MERTAYDIN46/EE_464_hardware_project/EE464 Hardware Project Presentation.pptx

## EE464 Hardware Project Presentation

Deniz Boran KARACA-
Mert Yaşar AYDIN-
Canberk DUMAN-

## Design Procedure

## Parameter Selection

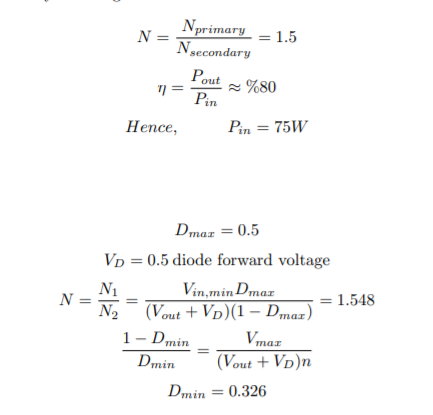
[picture p64: figure]

## Mosfet:

- Mosfet Rating:

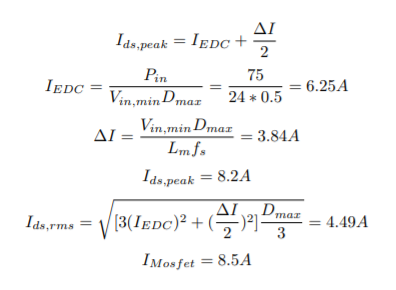
[picture p65: figure]

## Magnetizing Inductance

- Checking boundary magnetizing inductance:
- Choosing magnetizing inductance:

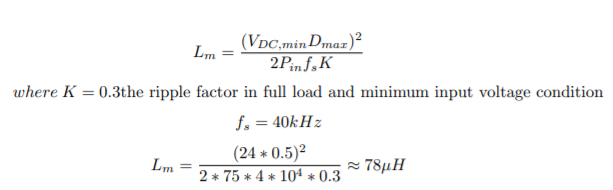
[picture p66: figure]

## Magnetic Design

- Average current of the transformer:

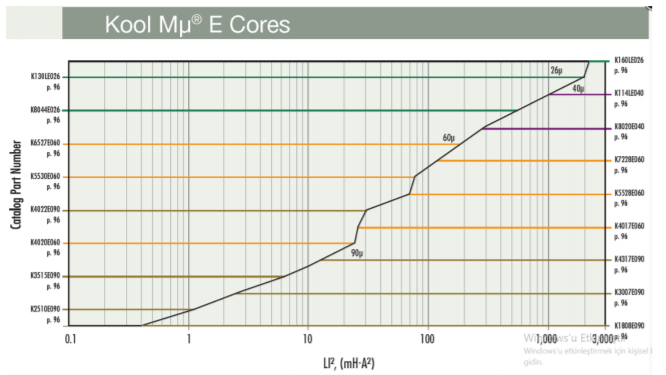
[picture p67: figure]

## Slide 7

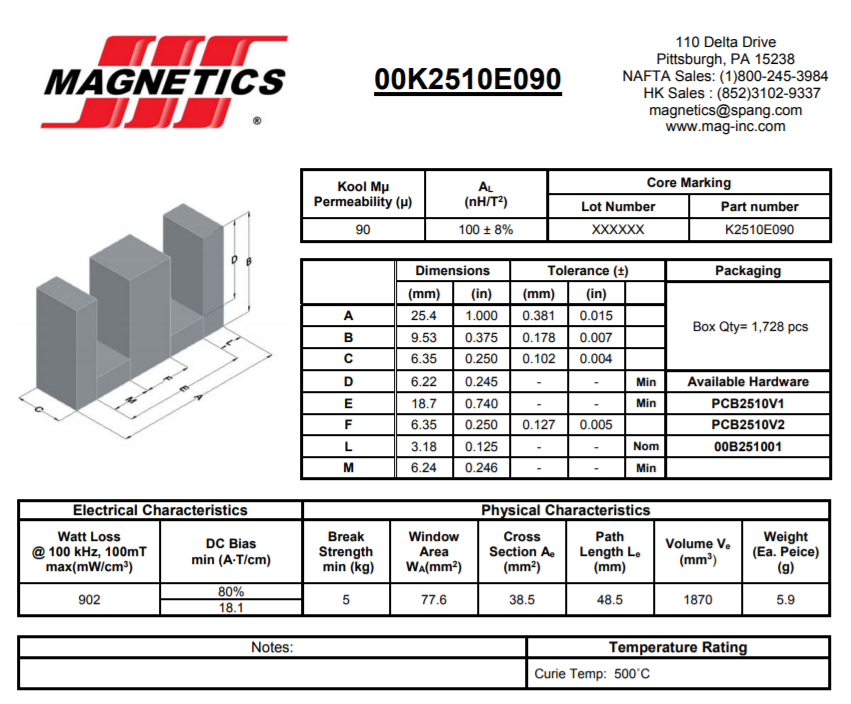
[picture p68: figure]

## Slide 8

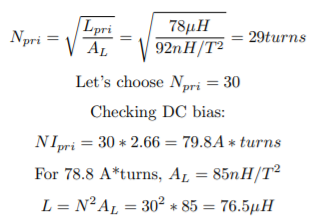
[picture p69: figure]
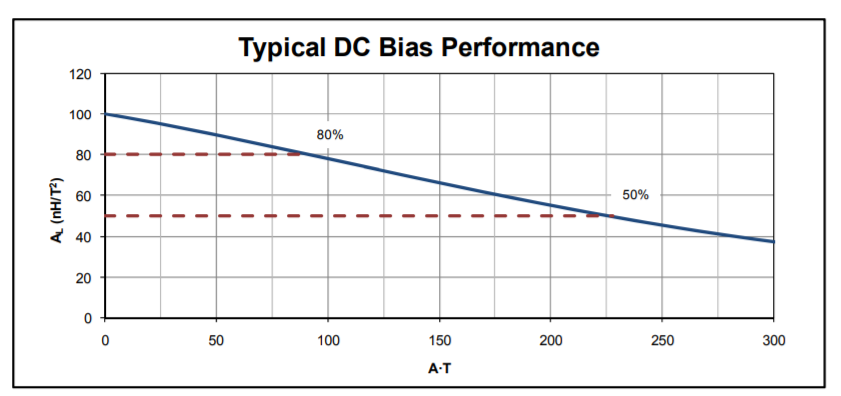
[picture p70: figure]

## Slide 9

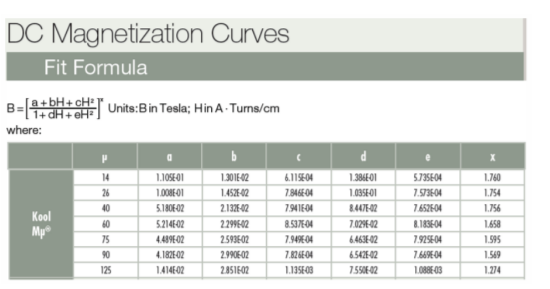
[picture p71: figure]
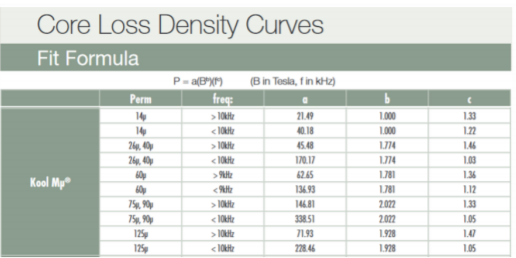
[picture p72: figure]

## Wire Selection

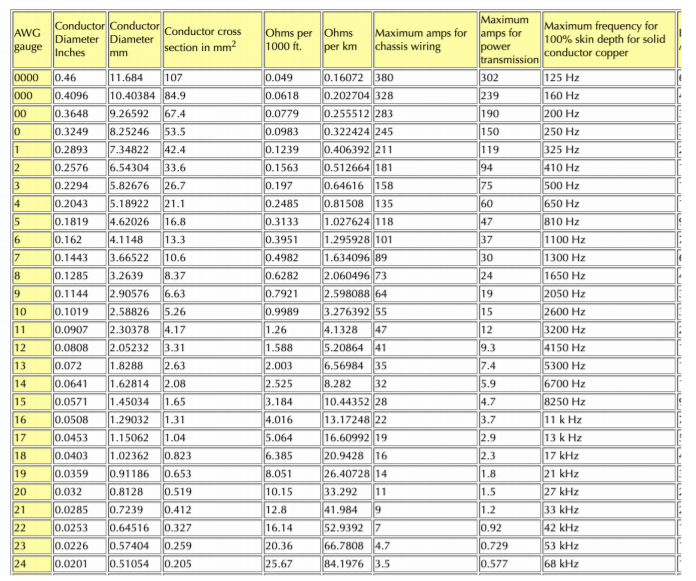
[picture p73: figure]
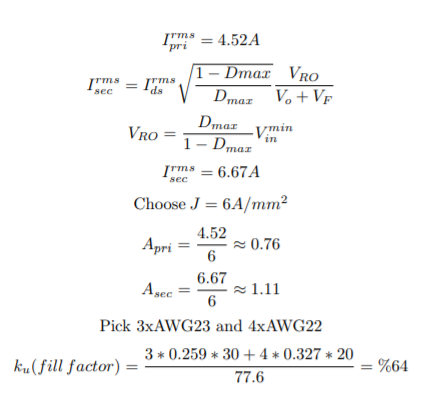
[picture p74: figure]

## Copper Loss:

- Neglecting proximity effect:

## Diode and Output Capacitor

- Diode:
- Output Capacitor:

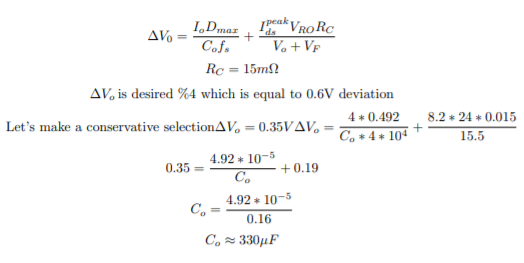
[picture p75: figure]

## Component Selection

## Slide 14

- Mosfet:
Assuming %30 spike
- Diode:

## Transfer Function Derivation

## On-Off States

- Averaging:

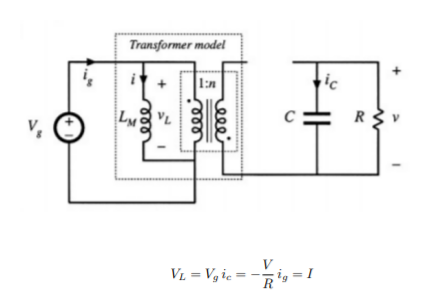
[picture p76: figure]
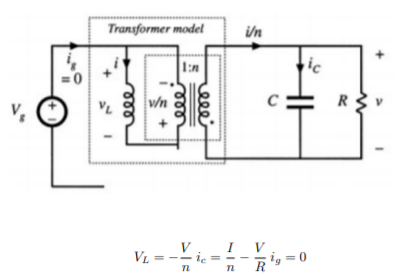
[picture p77: figure]

## Slide 17

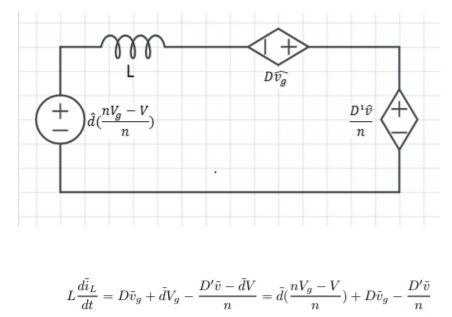
[picture p78: figure]
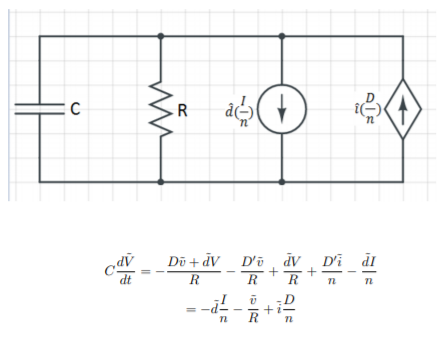
[picture p79: figure]
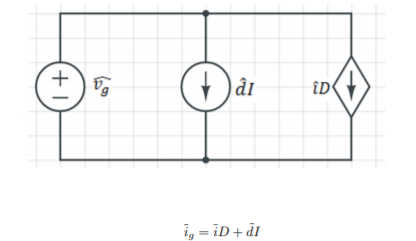
[picture p80: figure]

## Overall Circuit

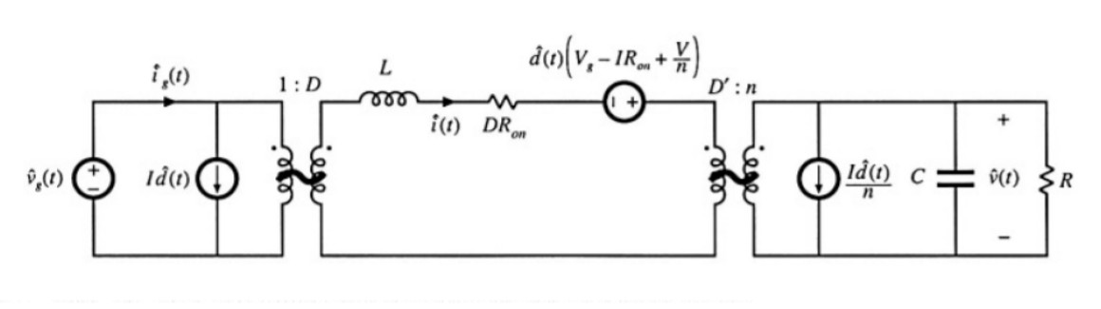
[picture p81: figure]

## Superposition

- Killing Voltage Source

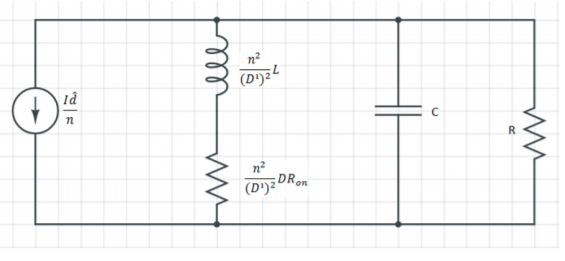
[picture p82: figure]
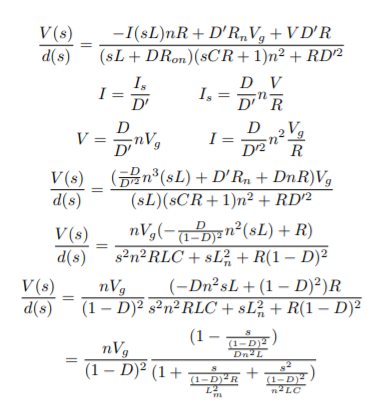
[picture p83: figure]

## Slide 20

- Killing Current Source

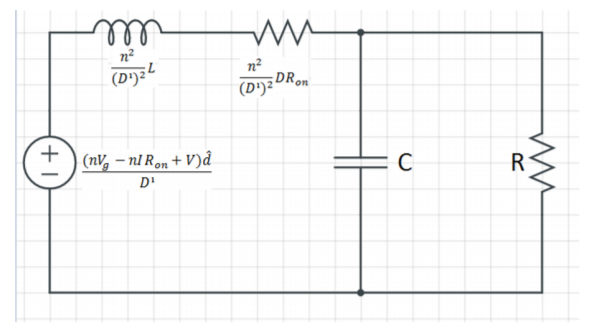
[picture p84: figure]
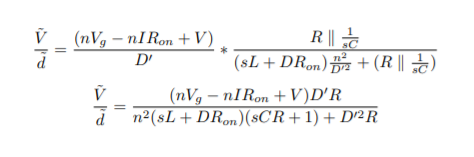
[picture p85: figure]

## Arranging Terms

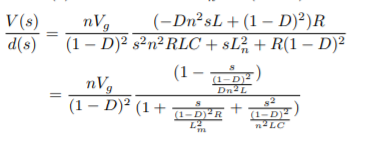
[picture p86: figure]

RHP Zero and Double pole!

## Compansator Design

## Bode Plots

- ESR of capacitor introduces a zero at:

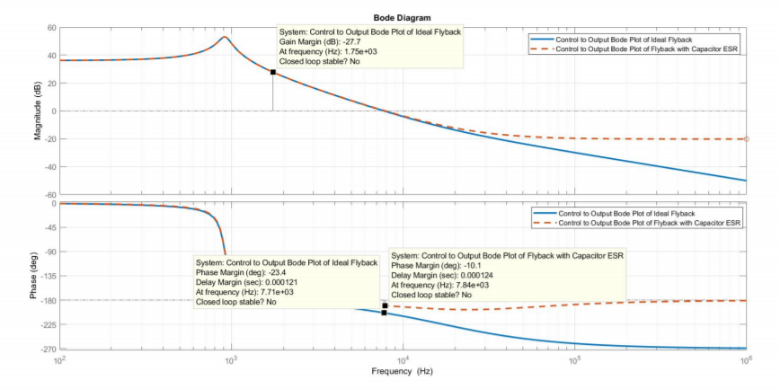
[picture p87: figure]

## Slide 24

- Crossover frequency selection:

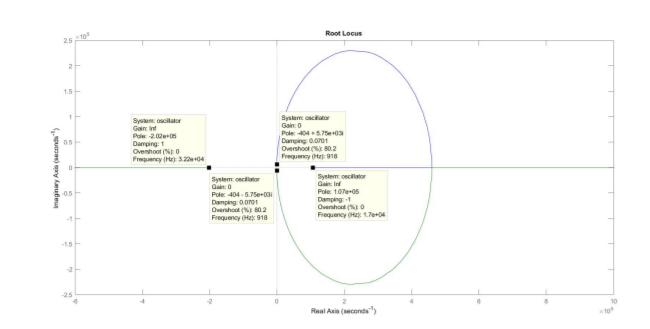
[picture p88: figure]

## Selecting Type of Error Amplifier

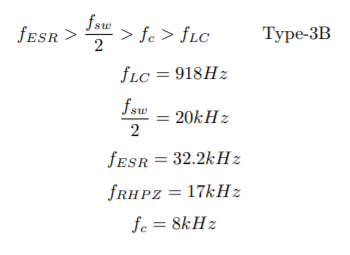
[picture p89: figure]
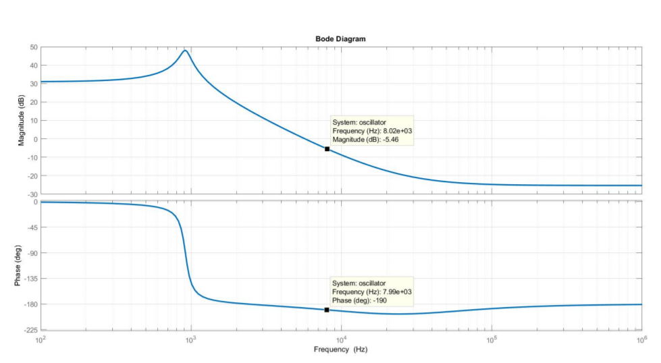
[picture p90: figure]

## Finding Components

- K-method:

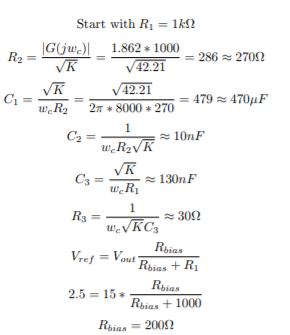
[picture p91: figure]
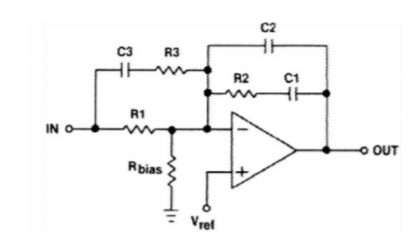
[picture p92: figure]

## Slide 27

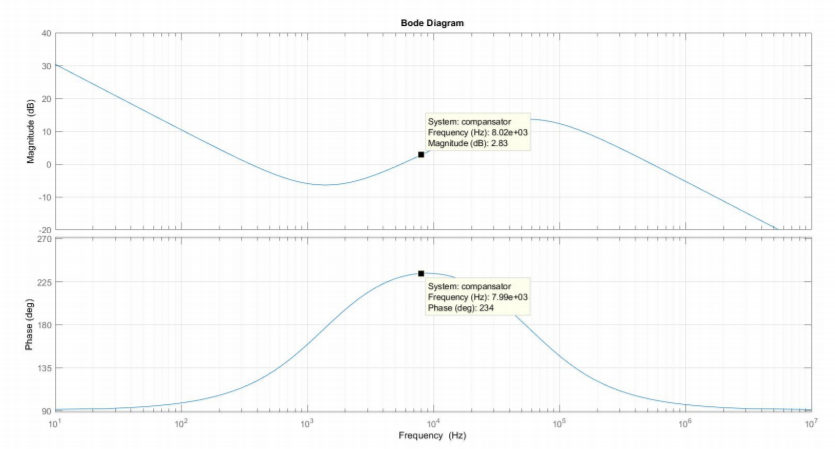
[picture p93: figure]
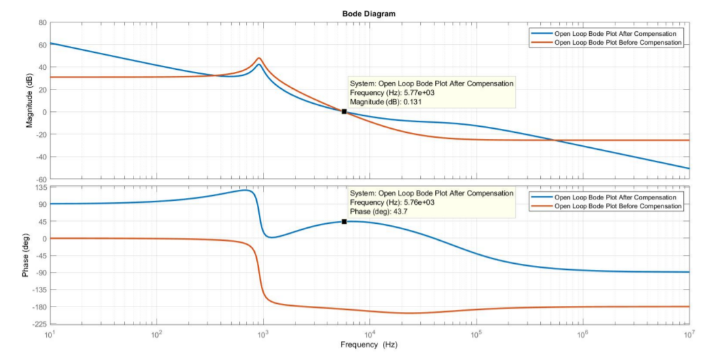
[picture p94: figure]

## Thermal Analysis

## Mosfet Heatsink

- Operating junction temperature is chosen 90 Celcius.

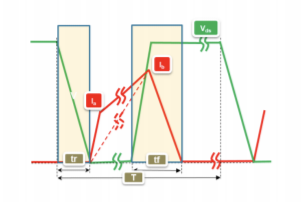
[picture p95: figure]
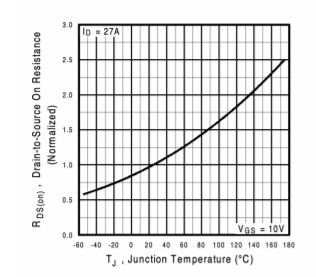
[picture p96: figure]
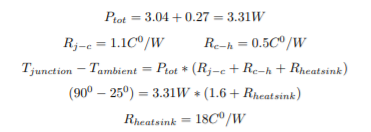
[picture p97: figure]

## Slide 30

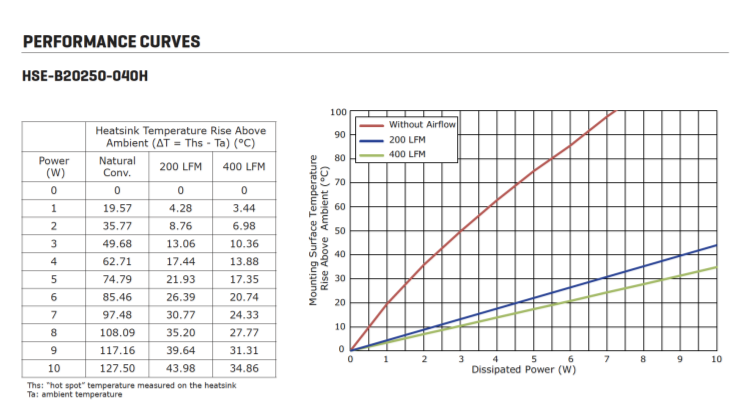
[picture p98: figure]

## Diode Heatsink

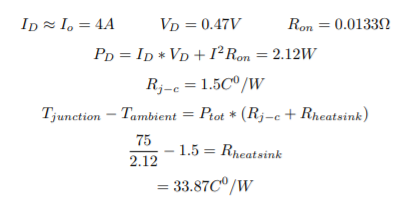
[picture p99: figure]
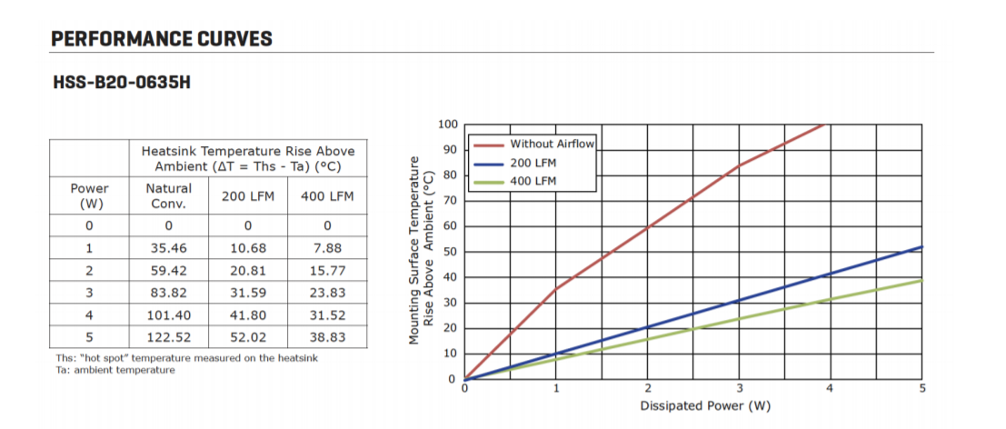
[picture p100: figure]

## Test Results

## With Controller Spice Model

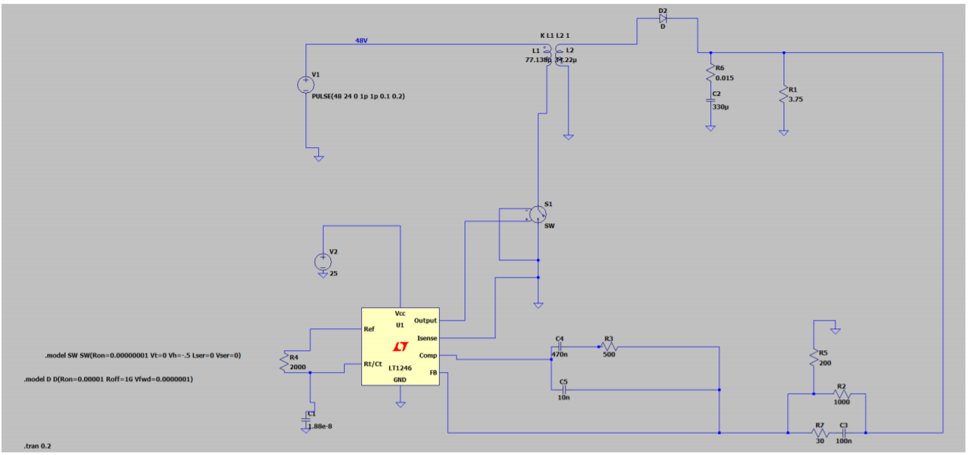
[picture p101: figure]

## Slide 34

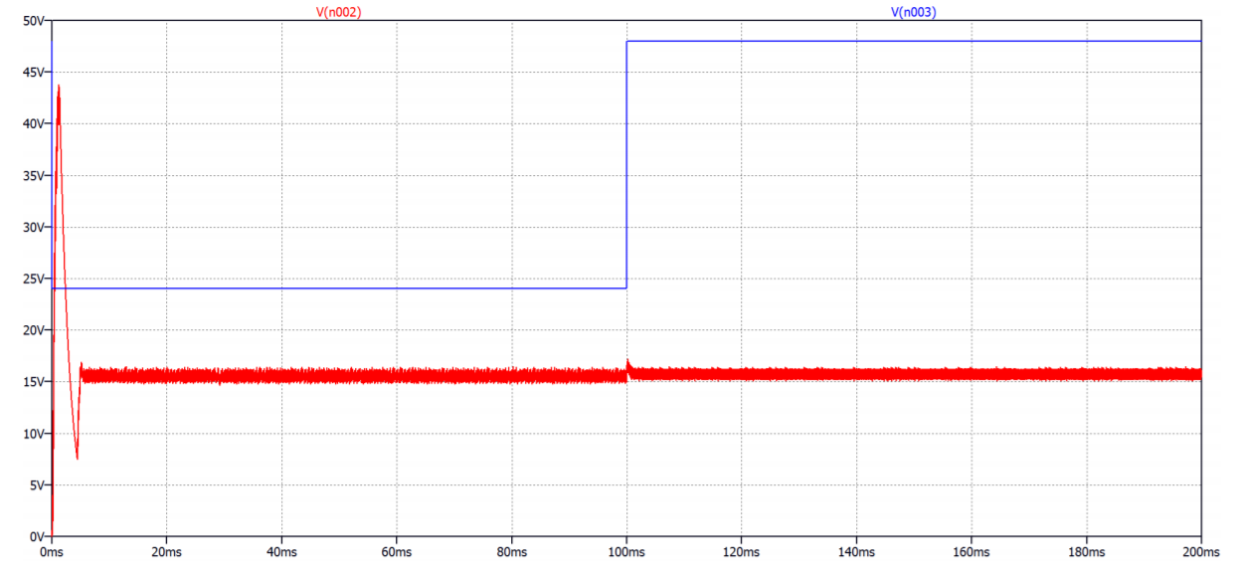
[picture p102: figure]

## Slide 35

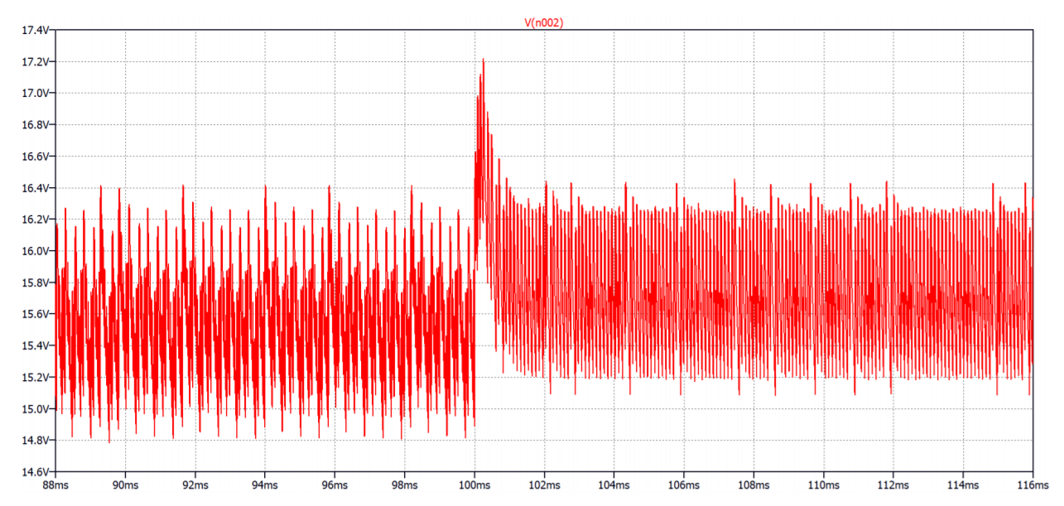
[picture p103: figure]

## Without Controller

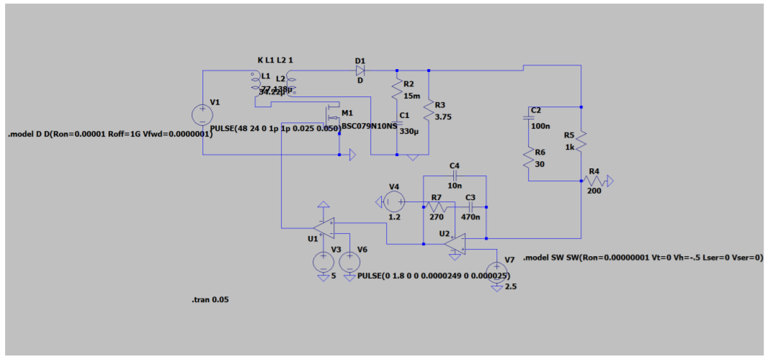
[picture p104: figure]

## Slide 37

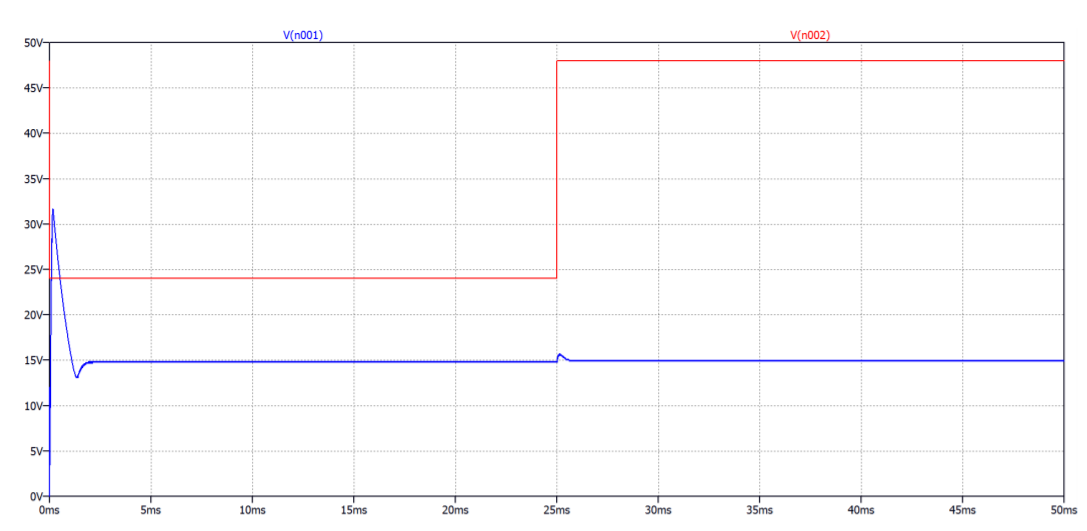
[picture p105: figure]

## Slide 38

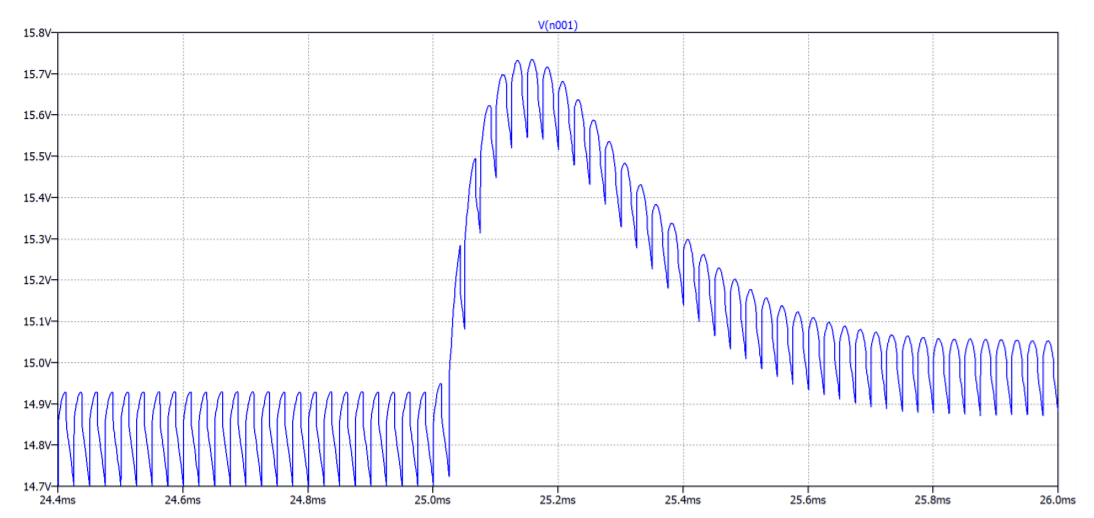
[picture p106: figure]
