MERTAYDIN46/EE_464_hardware_project/EE464_Hardware_Project_Simulation_Report.pdf

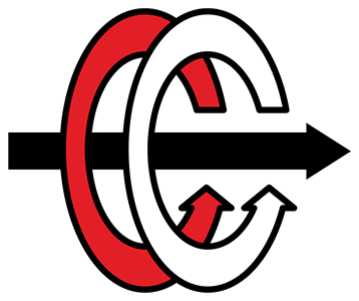
[picture p123: figure]

## MIDDLE EAST TECHNICAL UNIVERSITY

EE464- STATIC POWER CONVERSION-II

Hardware Project Simulation Report

Deniz Boran KARACA 2093987

Mert Ya¸sar AYDIN | 2093334
Canberk DUMAN | 2030450

Date: 23/03/2020

1

## Table of Content

1 Introduction | 3
2 Design Choices | 3
3 Design Process | 7
4 Simulation Results | 16
5 Conclusion | 20
6 References | 21

2

## 1 Introduction

This report is prepared to discuss design decisions, component selections and provide computer simulations of the regulated power supply for the EE464 hardware project.
There are mainly two different topologies and three different specs for each topology. In this report, both flyback and forward converters will be investigated with their advantages and disadvantages. The selection of topology and project design are explained with reasoning and simulation results.

## 2 Design Choices

### 2.1 Flyback Converter

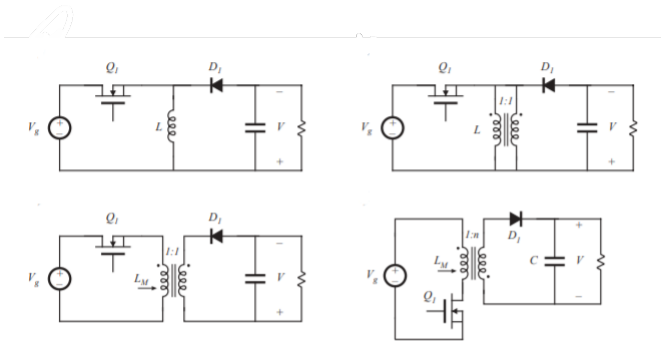
[picture p124: figure]

Figure 1: Derivation of the flyback converter.

The flyback converter can be described as the buck-boost converter with the isolated inductor wires, as seen in Figure 1. The isolation between primary and secondary sides is provided by a transformer. The transformer turns ratio depends on design specification and application, but mainly used to prevent results of possible internal failures on output and provide multiple outputs by adding more windings with a single input. They are generally used in the low to mid power range, less than 100 watts application. It also provides wide input voltage range.

3

Input output voltage relation of the flyback converter:

Vout

Vin

=

N2
N1

D
1 − D

There are also two different modifications of the flyback converter which are two-transistor and paralleling flyback converters, can be seen in Figure 2. These topologies can be answer of higher efficiency, lower cost or higher system reliability. Possible usage of these two modifications for our project will be discussed later.

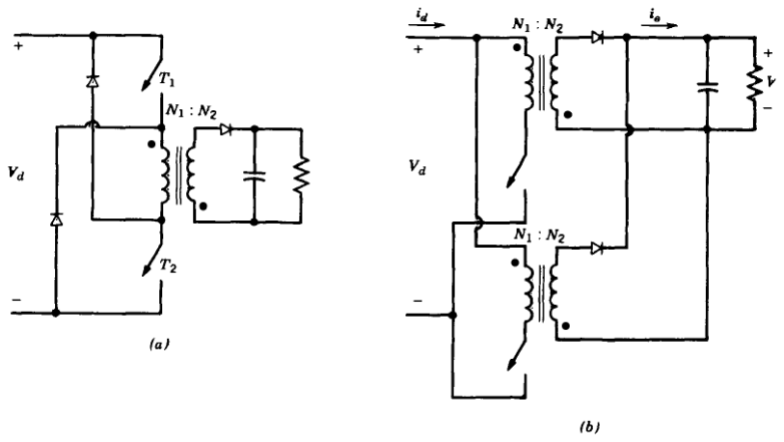
[picture p125: figure]

Figure 2: Two-transistor and paralleling flyback converters, respectively.

4

### 2.2 Forward Converter

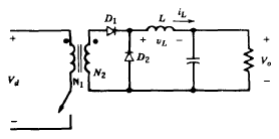
[picture p126: figure]

Figure 3: Practical forward converter.

The forward converter is derived from the buck converter employs a transformer for isolation between input and output sides, can be seen in Figure 3. It is possible to provide both higher and lower output voltages like the flyback converter. Even the forward converter looks like the flyback converter, it works in a different way. The forward converter passes energy directly to output by transformer, in contrast to the flyback converter which stores energy during conduction period and pass during non-conducting period. Moreover, since energy is not stored, gap-less core can be used.The forward converter is commonly used in the power range below 200 W.

Input output voltage relation of the forward converter:

Vout

Vin

=

N2
N1

D

In a practical forward converter, the transformer magnetizing current should be considered for a proper operation. To feed back the magnetizing energy to input supply which refers the higher efficiency, a third magnetizing winding is necessary.
There are also two different modifications of the forward converter which are two-transistor and paralleling forward converters like flyback, can be seen in Figure 4.

5

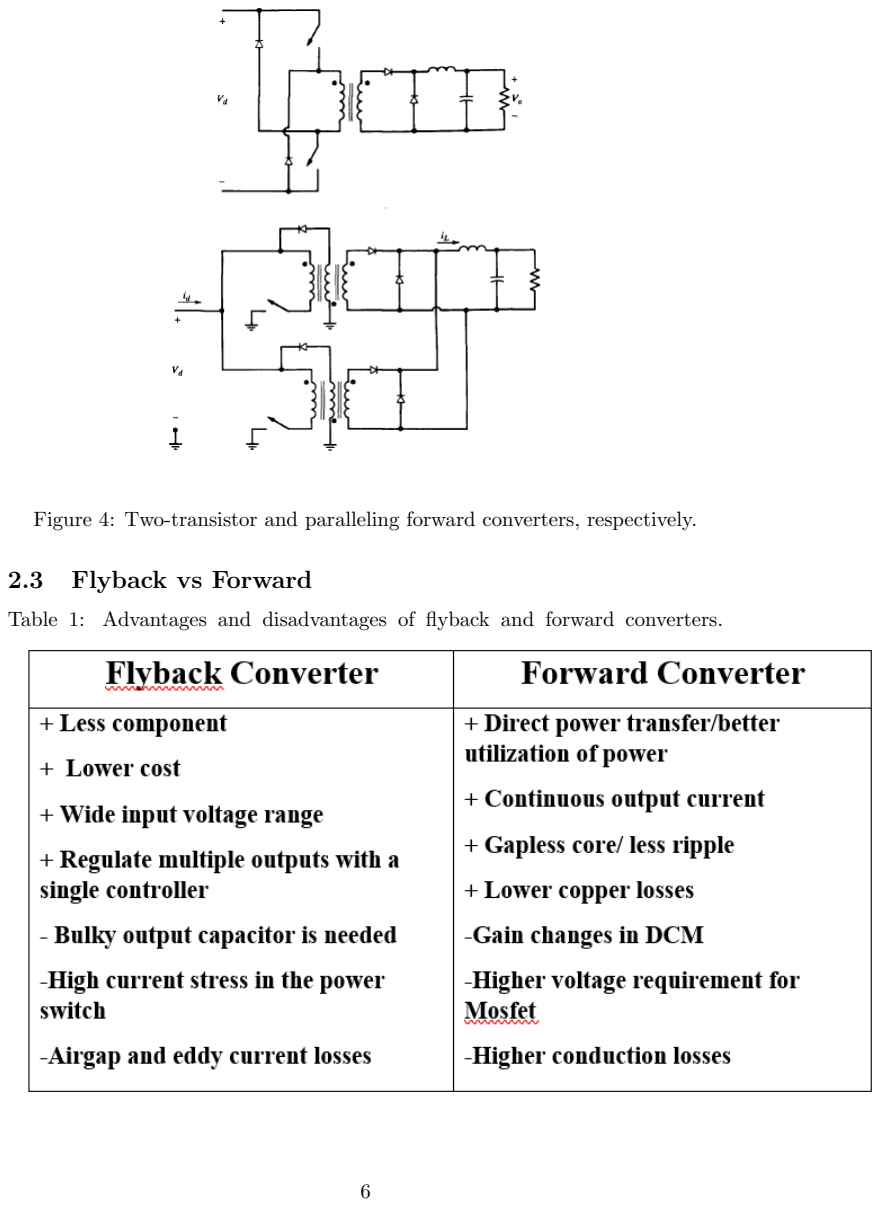
[picture p127: page 6]

Figure 4: Two-transistor and paralleling forward converters, respectively.

### 2.3 Flyback vs Forward

Table 1: Advantages and disadvantages of flyback and forward converters.

6

The main advantages and disadvantages of two topologies are discussed in Table 1. In hardware project, wide input voltage range is a important factor to reach stable and desired output voltage. In this respect, the flyback converter is better option. In addition to that, simplicity of less components and lower cost advantages of it are the main reasons to choose flyback converter topology. Compact design and high power density is another benefits of the flyback converter. Moreover, the flyback converter offers higher efficiency in low voltage range. The Fly 1 is preferred by taking all of these into account.

## 3 Design Process

Design specifications of the converter are very important during the design procedure. They are provided in Figure 5.


Figure 5: Design Specifications of the Flyback 1 Converter

Design procedure is explained step by step below. This procedure is simplified a bit. The more accurate design is made via the excel sheet prepared. That excel sheet is added to Github.

### 3.1 Step 1: Choosing Operating Condition

The first step is choosing the proper operating condition according to specifications. Flyback converters are used in continuous (CCM) or discontinuous (DCM) conduction mode. In order to ease the selection of operating condition, a helpful comparison shown in Table 2.

7

Table 2: DCM and CCM comparisons of the flyback converter.

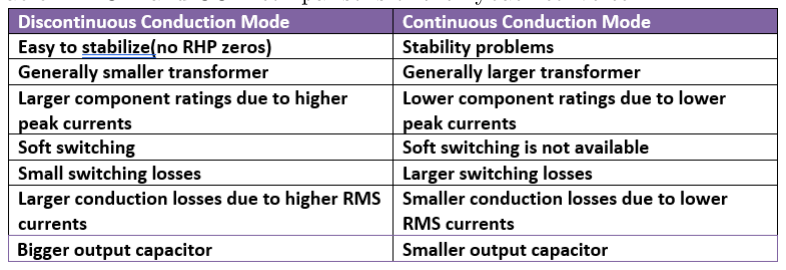
[picture p128: figure]

Note that CCM operation is mostly used high power and large output current applications. For that application, DCM is selected due to relatively low 4 A output current and 60 W output power. It provides stable operation. However, efficiency is important for that design. Therefore, three major implementations are considered in order to compensate the conduction loss of the DCM operation. Firstly, MOSFET having lower ON resistance is chosen. Secondly, a schottky diode is used. Lastly, resistance of the cables are lowered by using bigger ones, and fewer turns are used in transformer.

### 3.2 Step 2: Choosing Switching Frequency

There is a simple switching frequency trade-off. Higher switching frequency means higher switching loss and smaller components. Since an efficient converter wanted to be designed, a relatively small 40 kHz switching frequency is chosen.

### 3.3 Step 3: Choosing Controller:

First stage

Initially, since we are new in the converter control techniques and integrated circuits we are planning to use simpler controller while starting the project. For that purpose, we choose the “FAN 6604” IC. It has 6 pins and various features like built in soft-starting and current mode control. Also, its pwm frequency is very close to the one that we determined before therefore, we can use the all of out ratings with that controller.
FB pin still needs compensation network to determine performance of the controller. Gate pin is the output of that controller which is connected to “gate” of the power mosfet. Also, from the “SENSE” input we can give peak current feedback from the output of the converter and by this way the current mode control can be done. Additionally, HV pin provides soft starting by keeping PWM at very low values until its internal charges become full.

Second stage

In order to regulate the output voltage we need to implement some kind of feedback. In order to implement controller, if we are successful at first stage,we

8

are planning to use “UCC28780” integrated circuit .Beside providing PWM control feature for regulation purposes, it has multiple features that satisfy the requirements of the project. For example,it provides synchronous switching for active clamp snubber configuration which reverse the energy of the leakage winding to the source.
In order implement this operation pin 4 and pin 5 should be connected to the high side and low side gate drivers of the mosfets. Also, it can provide soft starting through the current sense input (pin 7). And another important feature of it is current mode control.

### 3.4 Step 4: Choosing Reflected Voltage

Making reflected voltage larger causes larger drain source voltage and lower peak current of the primary side MOSFET, and lower voltage stress on diode. Moreover, it also affects the maximum duty cycle of the converter. Maximum duty cycle generally has to be less than 65% due to possibility of transient problems. Reflected voltage is chosen as 31 V by considering all. Reflected voltage is symbolized as VRfor the rest of the design steps.

### 3.5 Step 5: Choosing Expected Efficiency

Choosing expected efficiency between%70-80 is reasonable. It is chosen as 80% since the output voltage is relatively higher, and an efficient flyback wanted to be designed.

Pin,max =

Pout
η

=

60
0.8

= 75W

VMosf et(on) =

Vin,min + VR

1 + | Vin,min∗VR
| Pin,max∗RDS(on)

Assuming on state resistance of a MOSFET having low ON resistance is 0.05 ohm:

VMosf et(on) = 0.275V

Dmax =

VR

(Vin,min − VMosf et(on)) + VR

Dmax = 0.566

Primary side peak current:

Ipri(peak) =

Pin

Vin,min − VMosf et(on)

2

Dmax
Ipri(peak) = 11.17A

9

### 3.6 Step 6: Transformer Design

Firstly, maximum primary inductance value provides converter operate in DCM is found.

Lpri,max =

Vin,min ∗ Dmax

Ipri(peak) ∗ fsw

Lpri,max = 30.1µH

Increasing primary inductance over the maximum value can make converter operate in CCM for high duty cycle values. In other words, if the maximum value is chosen converter is in the boundary between DCM and CCM for minimum input voltage value.

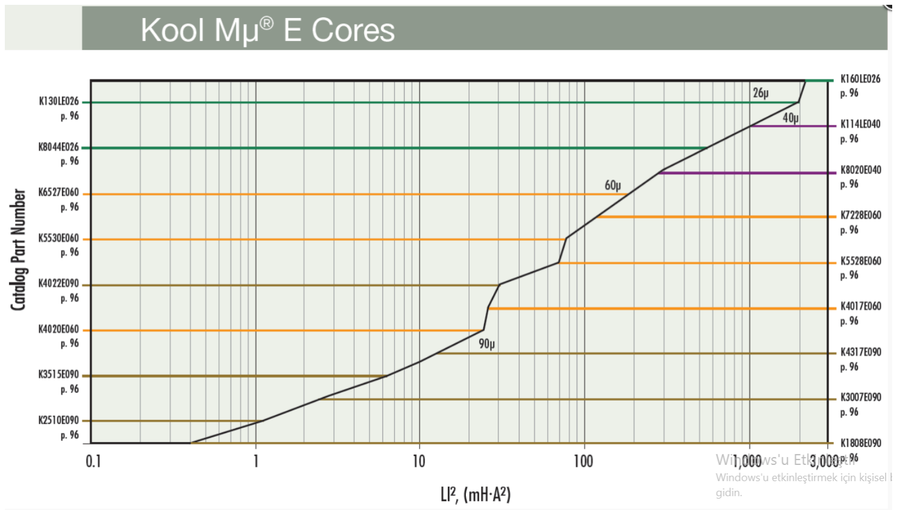
[picture p129: figure]

Figure 6: LI² Characteristics of Kool Mu E Cores [1]

In order to select the proper core, the graph in the Figure 6 is investigated.

Lpri,max ∗ I

2

pri(peak) = 3.75mH.A²

K3515E090 core can be used from 0.1 to 7mH.A²
. Since it is small and capable for that operation, it is chosen as the transformer core. Turn ratio is simply:

n =

VR

Vout + VD

10 where VD is the diode forward voltage and generally around 0.5 V for schottky diodes. Therefore,

n = 2

Then, minimum primary turns are found with two different equations as follows:

Npri,min =

Lpri ∗ Ipri(peak)

Bmax ∗ Ae
Npri,min = 4turns

Note that Ae can be found from core datasheet [2], and saturation flux density is shown in Figure 7.

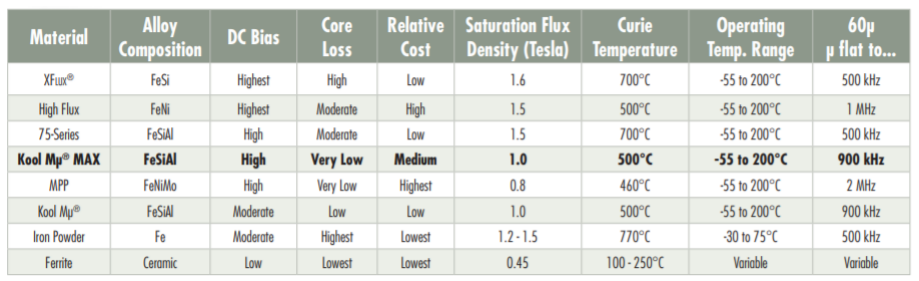
[picture p130: figure]

Figure 7: Material Properties of Kool Mu [3].

To avoid magnetic saturation, second equation is:

Npri,min =

r
Lpri
AL

=

r
30.1 ∗ 10⁻⁶
146 ∗ 10⁻⁹

= 14.36turns

AL value is found from core datasheet. Primary side turn number is selected as 16 turns considering both equations. Therefore Nsec becomes 8 turns.
Then, required minimum airgap to get desired primary inductance value is calculated as follows:

Lgap = µ0Ae

N²
pri
Lpri

−

Ic
µr

= 0.126mm

lc is core magnetic path length and µr is the relative permeability. They are found from core datasheet.

Step 6: Choosing Wire Size

Choosing a proper wire for transformer windings is very crucial since the wires need to carry such primary and secondary side currents. First step for wire size

11 selection is estimating total transformer loss.

Ptot =

∆T

Rth(core)

∆T = Tmax − Tamb

By limiting T to 100 ◦

, and assuming ambient temperature is 25◦ :

∆T = 75C

◦
(1)

Moreover, Rth(core) can be estimated as:

Rth(core) = 23 ∗ AP⁽⁻⁰.37)

AP = WAAe = 12.7cm⁴

Window area is also found from core datasheet.

Ptot = 8.3W

Secondly, actual flux swing is found as follows:

∆B =

Ipri(peak)Lpri

NpriAe

10⁴

∆B = 0.25T

By neglecting the core losses, primary and secondary side resistances are:

Rpri =

Ptot
2I

2
pri(RMS)

Ipri(RMS) = Ipri(peak)

r
Dmax
3

= 4.822A

Rpri = 0.178Ω

Rsec =

Ptot
2I

2
sec(RMS)

Isec(peak) = Ipri(peak)

Npri

Nsec

= 22.32A

Isec(RMS) = Isec(peak)

r
1 − Dmax
3

= 8.55A

Rsec = 0.083Ω

Minimum primary and secondary side wire cross sectional area:

Apri,min =

p100NpriLt

Rpri

Asec,min =

p100NsecLt

Rsec

12

Lt is the turn length and depends on the bobbin used, and it can be assumed as 50 mm for that core. p100 is the limited temperature copper resistivity, and 2.303 ∗ 10⁻⁶Ωcm for 100 C
◦
. Therefore,

Apri,min = 1.03mm²

Asec,min = 1.1mm²

Before going further, considering skin effect is very important. For a reliable operation, the radius of conductor is smaller than skin effect.

skindepth =

r p100

π ∗ fswµcopper

skindepth = 3.26mm

Lastly, proper wire size is determined according to chart in Figure 8. AWG 16 cable is selected for now. However, cable size can be enlarged in order to decrease the conduction losses later. AWG 16 cable is also appropriate for skin effect consideration.

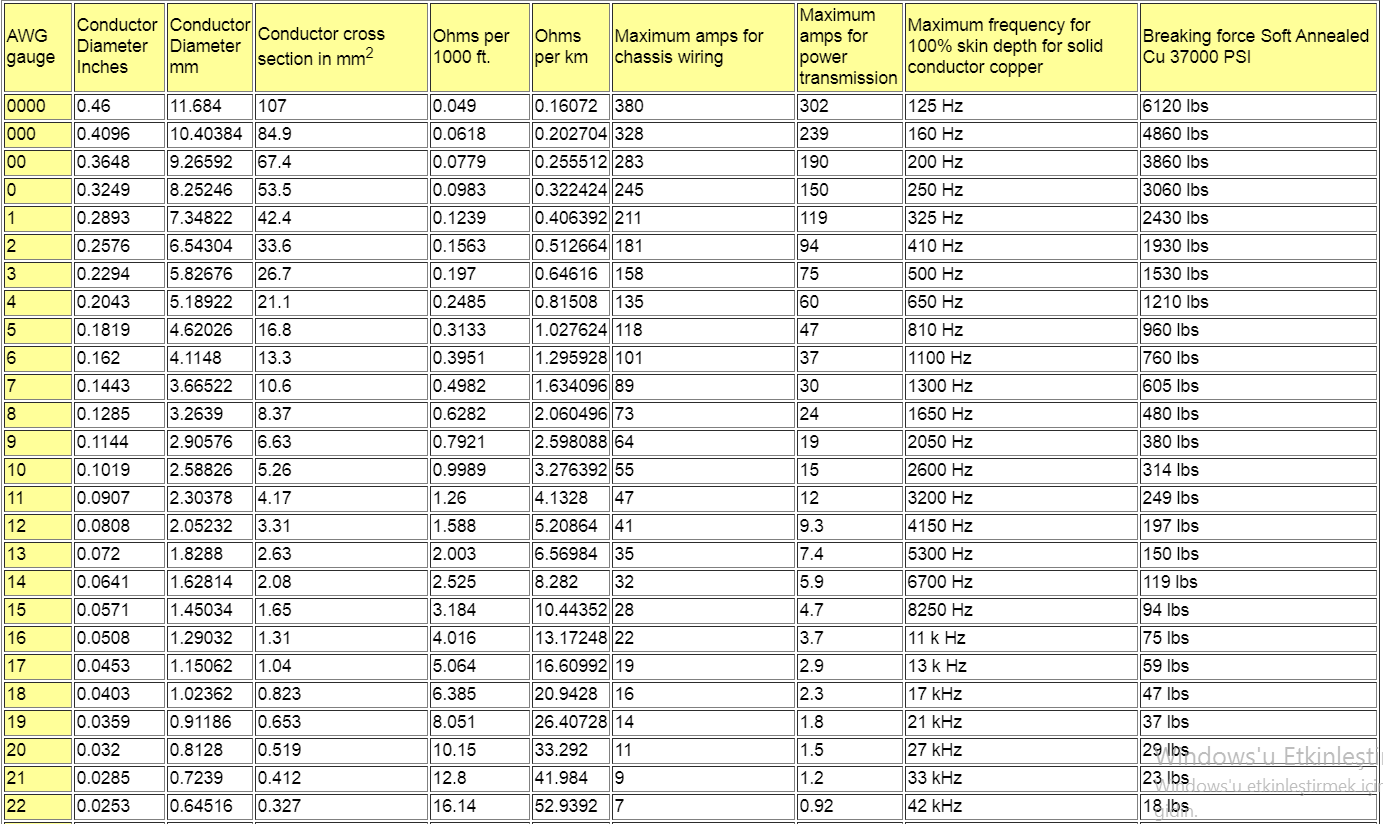
[picture p131: figure]

Figure 8: AWG Copper Chart

Step 7: Choosing MOSFET

As mentioned before, since rectifier operates in DCM switching losses are small. In order to reduce the conduction losses, a MOSFET having small ON resistance is selected.

13

Maximum current flowing through the MOSFET is primary side peak current. Although considering RMS current is pretty enough during component selection, peak currents provides some margin and more reliable operation. Therefore,

Irated(Mosf et) > Ipri(peak) = 11.6A

Voltage rating of the MOSFET is calculated as follows:

Vrated(Mosf et) = Vin,max + VR + Vspike

Assuming expected maximum spike voltage is 30 % of maximum input voltage. Note that that spikes are decreased with a clamp circuit.

Vrated(Mosf et) = 48 + 31 + 14.4 = 93.4V

For that purpose, 100V 33A 0.044 ohm IRF540NSPbF [4] MOSFET is selected.

### 3.7 Step 8: Choosing Diode

Similarly, in order to decrease the conduction losses, a schottky diode is chosen.

Vrated(diode) = Vout + Vin,max

Nsec

Npri

= 39V

Irated(diode) > Isec(peak) = 22.32A

Secondary peak current is considered due to more reliable operation. Moreover, 30% margin is added to voltage rating. At the end, a schottky diode whose ratings are over 50V and 22.32 A is selected. For this purpose, 80 V 30 A VT3080S [5] is chosen. It’s forward voltage drop is typically 0.5-0.6 V.

### 3.8 Step 9: Choosing Output Capacitor

Since rectifier is operating on DCM, and higher peak currents flow through the components, ESR of the capacitor becomes important.

Ccap >>

IoutDmax

fswVripple

Ncp is a value between 10-20, and allowable maximum ripple for that case is 0.6
V. Taking it as 10,

Cmin = 9.3µF

Calculating maximum ESR:

ESRmax =

Vripple

Isec(peak)

= 0.0268Ω

Vrated(cap) = Vout = 15V

At the end, 50 V 330 µF 23 mΩ aluminium electrolytic capacitor [6] is chosen.

14

### 3.9 Step 10: RCD Clamp Circuit Design

During the off time, high voltages may occur due to leakage inductance of the transformer and they may damage the MOSFET. Therefore, a clamping circuit shown in Figure 9 is designed. The components of that circuit depends on the primary leakage inductance, so they may be changed after measuring the leakage inductance in practice. For theoretical calculations, leakage inductance is taken as 3% of the primary inductance.
Note that there are different type of clamping techniques, and the selected topology may be changed since it may decrease the efficiency in a considerable amount. For now, a simple RCD snubber is functional enough.

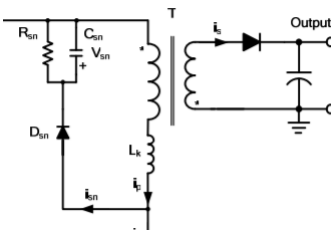
[picture p132: figure]

Figure 9: RCD Snubber Topology [7]

In that topology, higher R value causes low power loss but high voltage spike. Moreover, lower R value causes more oscillations. Components will be chosen according to simulation results considering the MOSFET ratings.
Note that ratings of all of these selected components will be ensured with simulation results. If there is a discrepancy between theoretical and simulation results, selected components will be changed. Moreover, different application notes of different companies are investigated before starting to design that converter. Their information is mixed and used.

15

## 4 Simulation Results

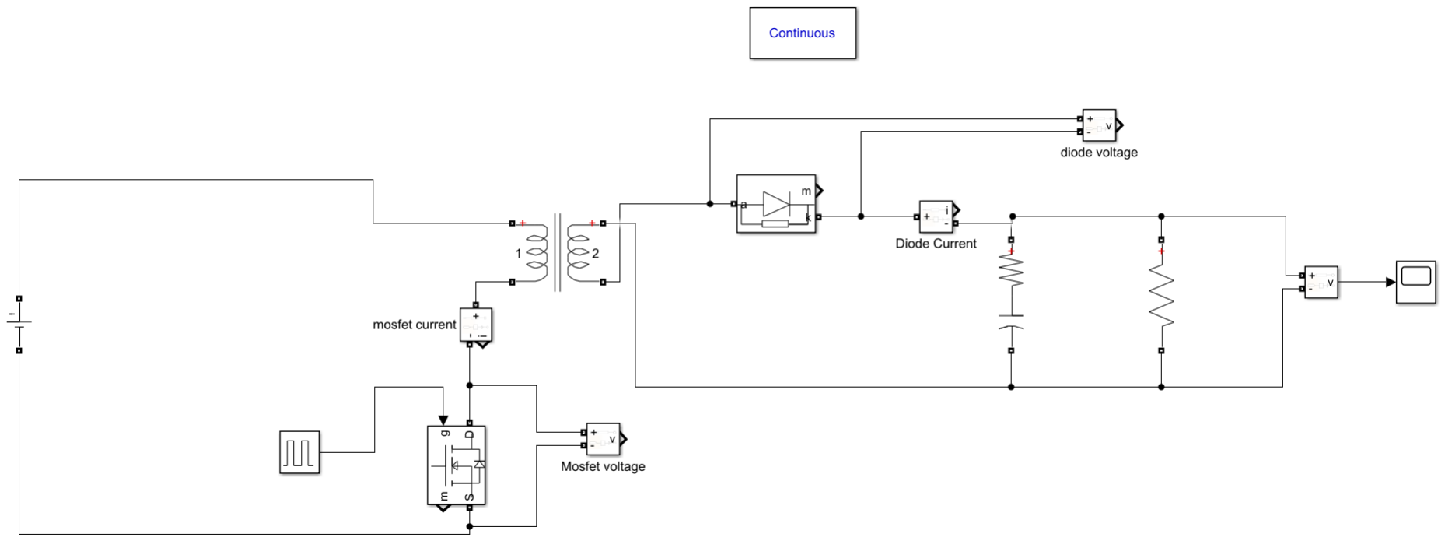
[picture p133: figure]

Figure 10: Circuit diagram of the project.

### 4.1 Output voltage verification

In order to observer how much the duty cycle is deviated from the ideal case to compansate non linearities.

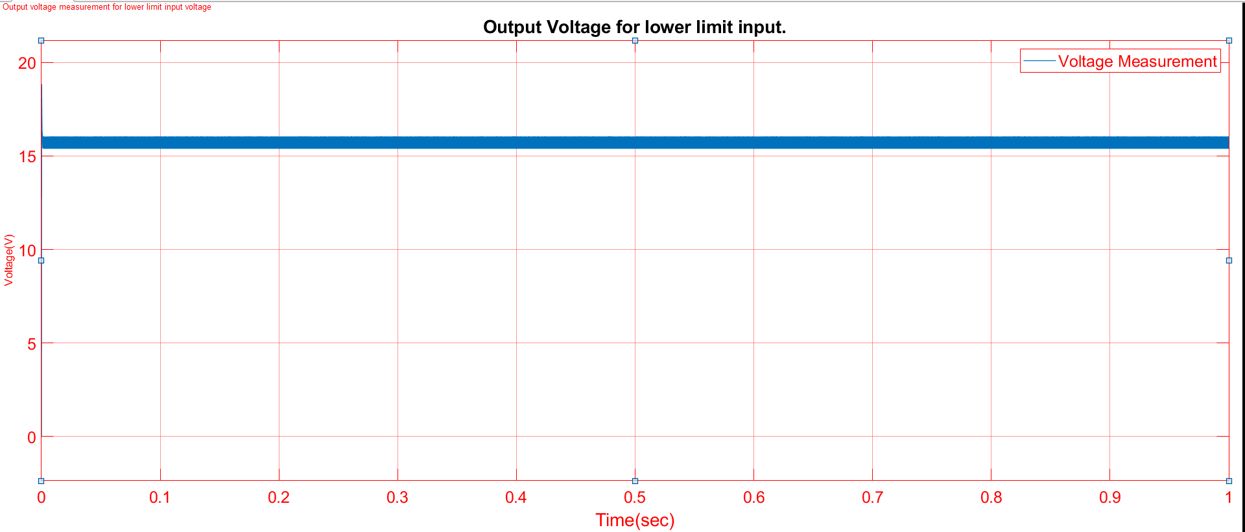
[picture p134: figure]

Figure 11: Output voltage verification.

16

### 4.2 Diode ratings

This simulation is done such that the duty cycle is the value that creates most voltage stress on the diode and also highest current.

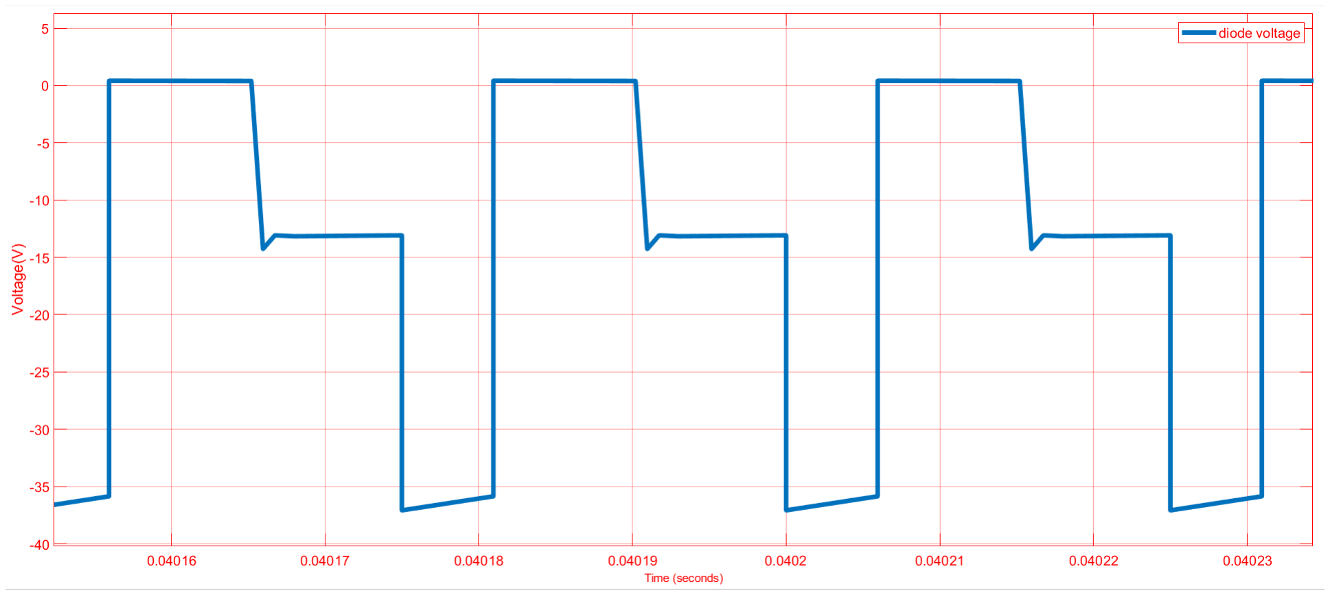
[picture p135: figure]

Figure 12: Voltage stress on the diode.

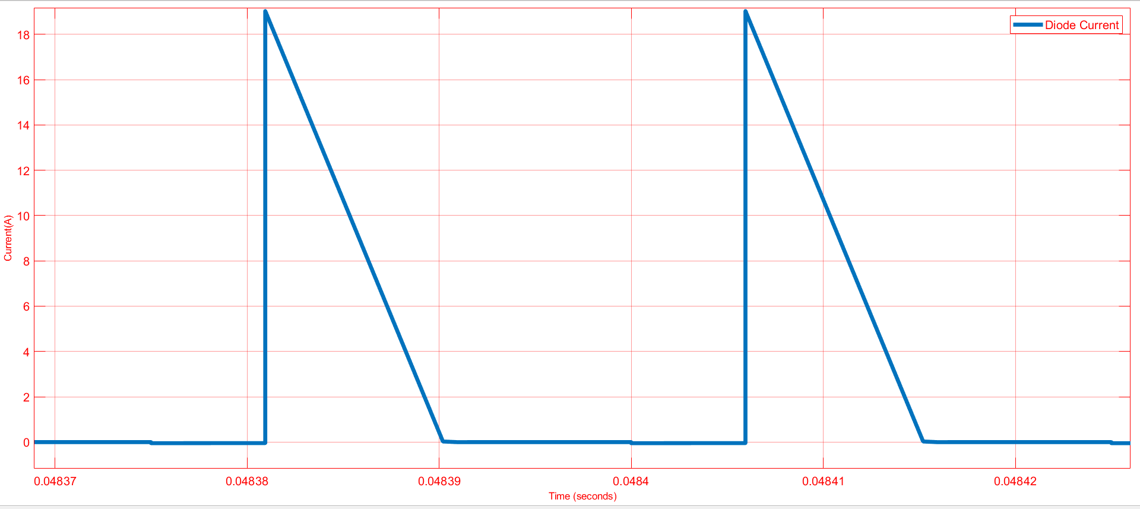
[picture p136: figure]

Figure 13: Current stress on the diode.

### 4.3 Mosfet ratings

This simulation has been done under the conditions where the mosfet current and voltage at its highest value.

17

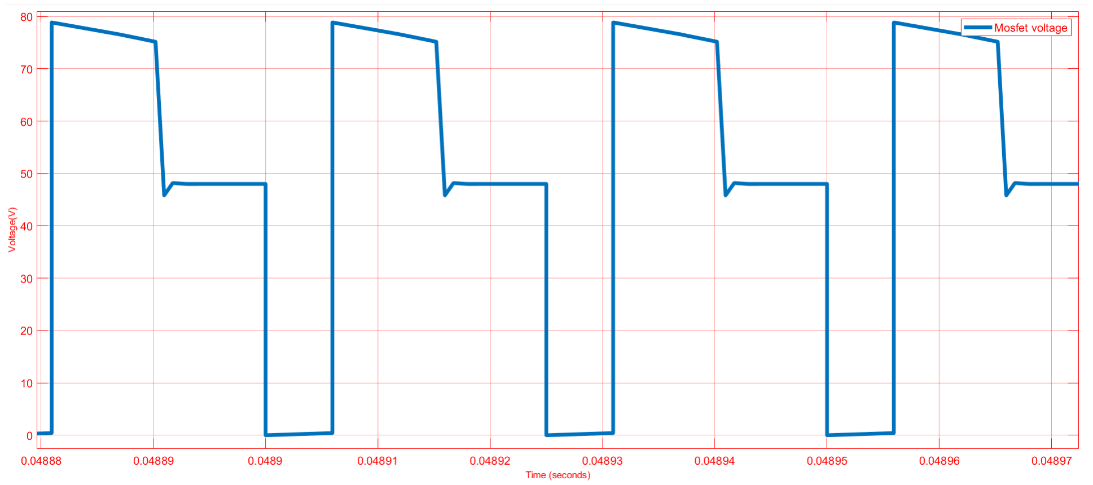
[picture p137: figure]

Figure 14: Voltage stress on the mosfet.

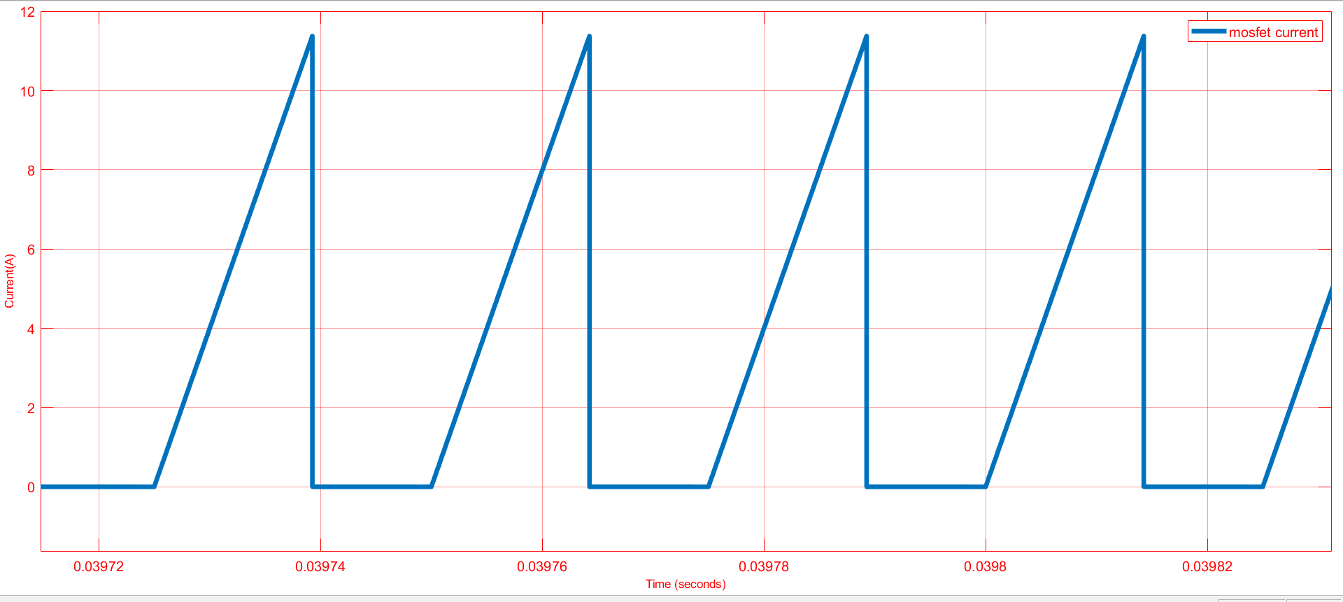
[picture p138: figure]

Figure 15: Current stress on the mosfet.

18

### 4.4 Output ripple

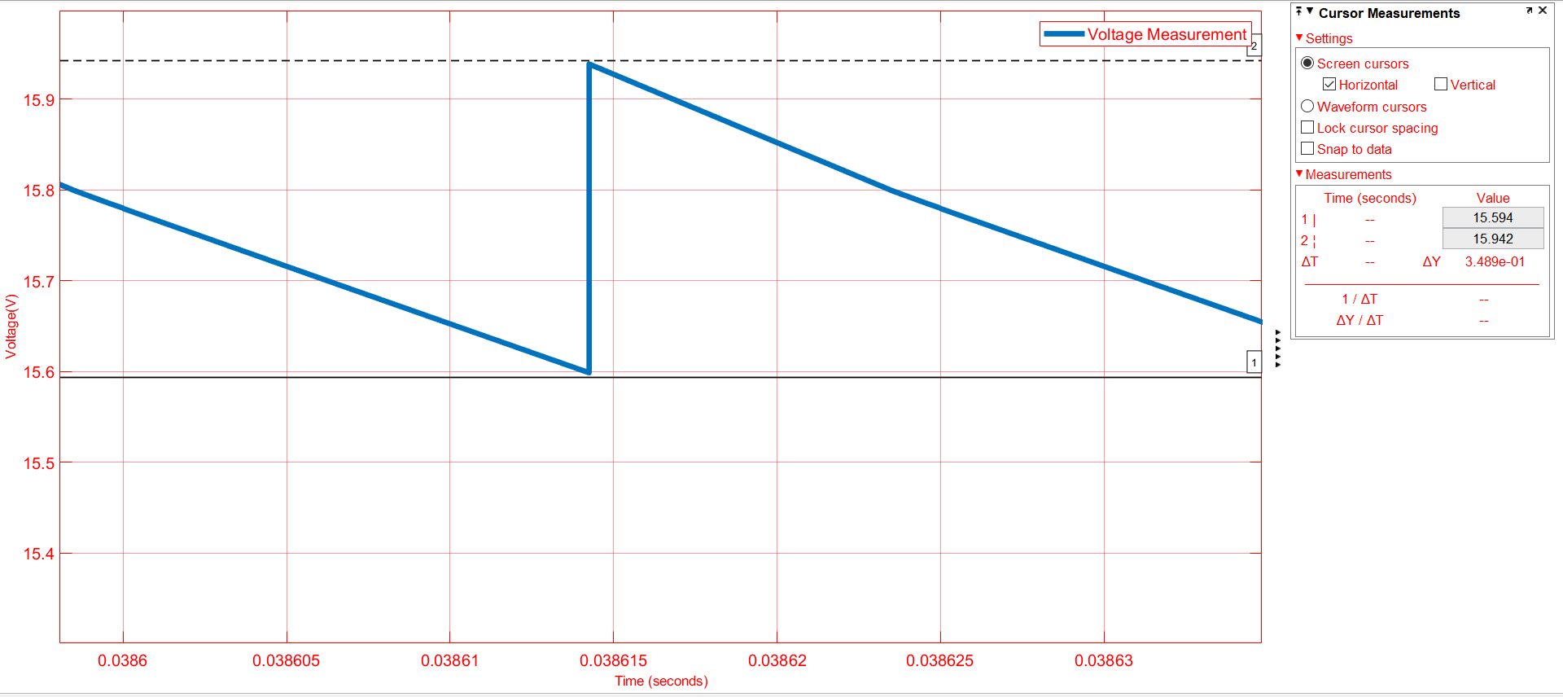
[picture p139: figure]

Figure 16: Output ripple.

Output voltage ripple is approximately %2.5 according to the simulation result.

### 4.5 Snubber

Snubber is designed not to exceed our mosfet voltage limit and also providing enough time to dissipate the energy on the leakage inductances.

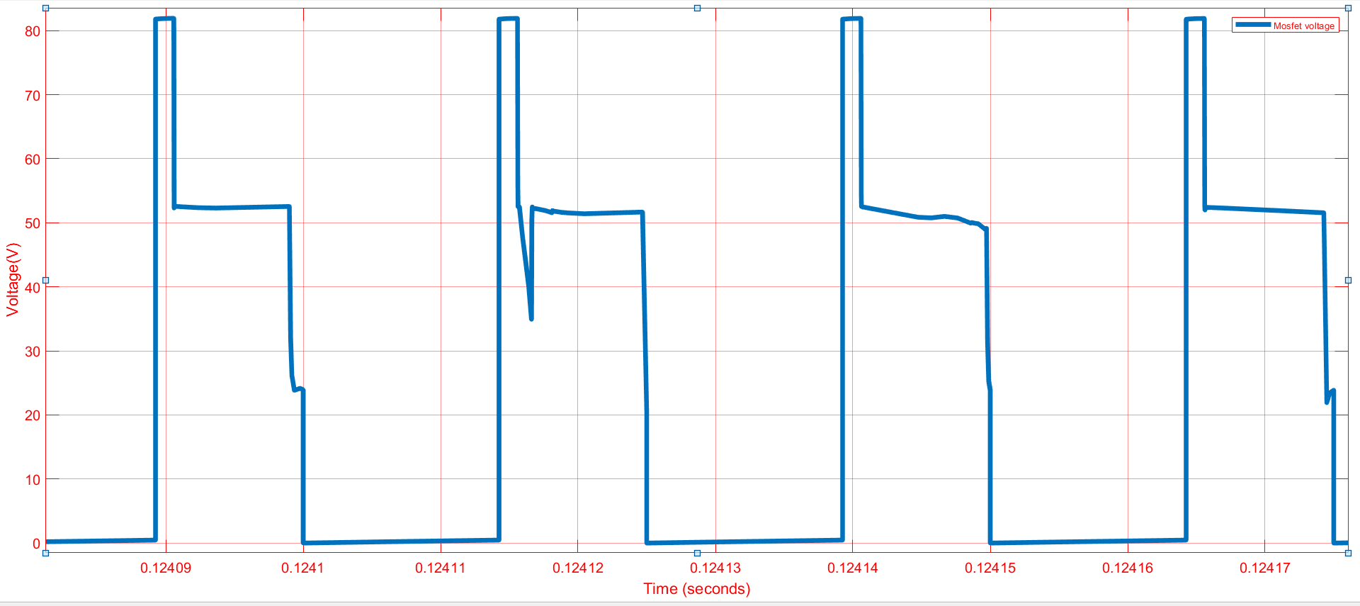
[picture p140: figure]

Figure 17: Voltage stress on the mosfet with snubber.

19

### 4.6 Efficiency

Efficiency is calculated with same schematic. It is found as 0.85 for maximum duty cycle value as shown in Figure 18.

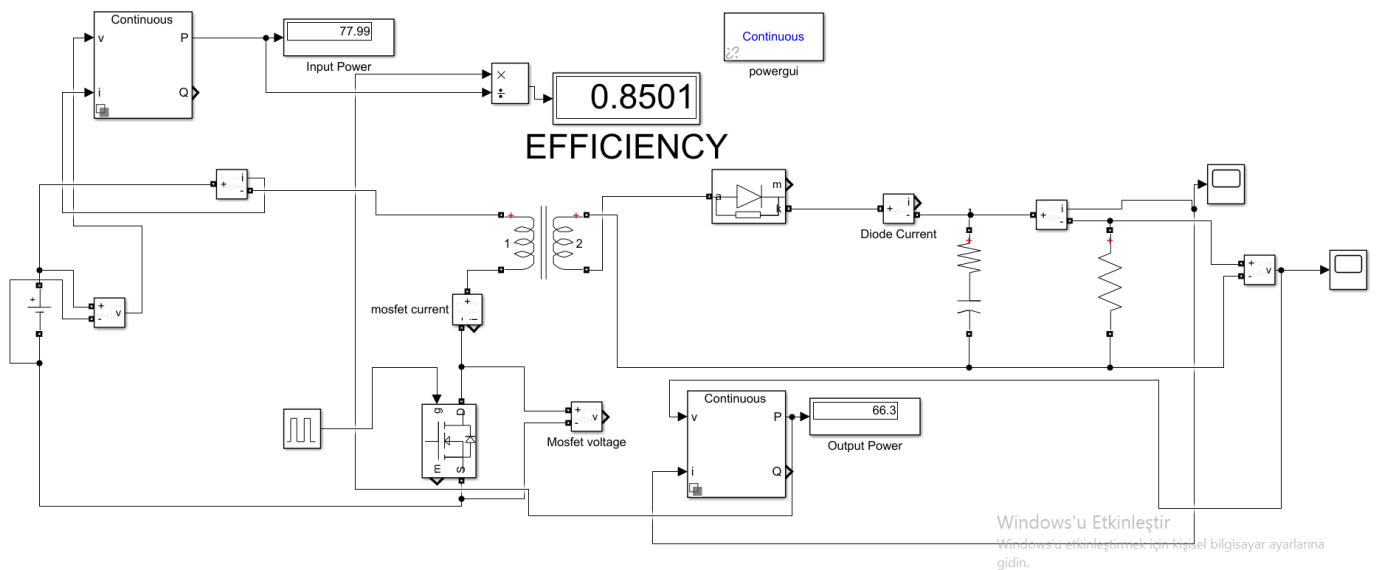
[picture p141: figure]

Figure 18: Schematic for efficiency calculation.

With these simulation results, it is proven that components selected in design steps are appropriate for that operation.

## 5 Conclusion

In that project, a flyback converter with certain specifications is designed. Before starting to the design process, a very comprehensive research is made. All necessary points of the design is considered, and the best solution is tried to develop between countless tradeoffs. Actually, these points are not just conceptual ideas but also the design arguments that are supported by very detailed simulation results.Also, An excel sheet is formed to understand the tradeoffs of the system better. In the comparison part, we explain why we chose that topology to forward converter and in the design part, we have followed some design steps to reach and finalize every detail of the project. That part has very solid calculations and promising decisions about the components of the project additionally not just components itselves but the way we use them is explained at there , Finally, we have shown that our design decisions are very much correct by using simulink design tool in the simulation result part At the end, a functional solution is developed for that purpose. All necessary points of the design process and simulation results are stated in that report. That project is very beneficial since it helps students to become engineers. Considering a variety of pros and cons prepares them to the professional career. It is a very good contribution to the students practical knowledge. Even if theoretical knowledge of them is enough, facing with real life problems is very crucial in power electronics to develop themselves. Converter was designed easily on the

20 paper. However, as expected, there will be much bigger problems during the implementation but these problems will be overcome again as always.

## 6 References

[1]= Kool M

R Material Curves. (n.d.). Retrieved from https://www.mag-inc.com/Products/Powder-Cores/Kool-Mu-Cores/Kool-Mu-Material-Curves
[2]= (n.d.). Retrieved from https://www.mag-inc.com/Media/Magnetics/Datasheets/00K3515E090.pdf[3]= (n.d.). Retrieved from https://www.mag-inc.com/Media/Magnetics/File-Library/Product
[4]= (n.d.). Retrieved from https://pdf.direnc.net/upload/irf540nspbf-datasheet.pdf
[5]= (n.d.). Retrieved from http://www.vishay.com/docs/89242/vt3080s.pdf
[6]= (n.d.). Retrieved from https://www.mouser.com.tr/datasheet/2/315/ABA0000C1255-
1128316.pdf
[7]=(n.d.). Retrieved from https://www.monolithicpower.com/en/documentview/productdocument/index/version/2/documenttype/Application

21
