MERTAYDIN46/EE_464_hardware_project/compansator design.pdf

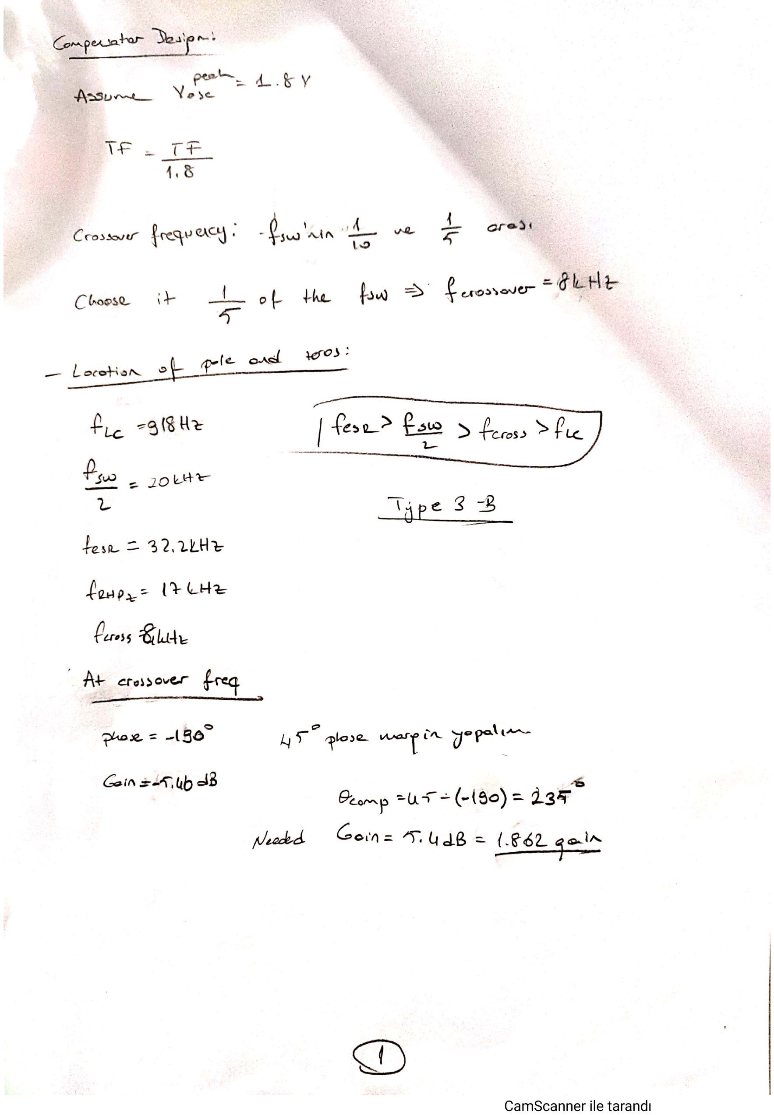
[picture p142: page 1]
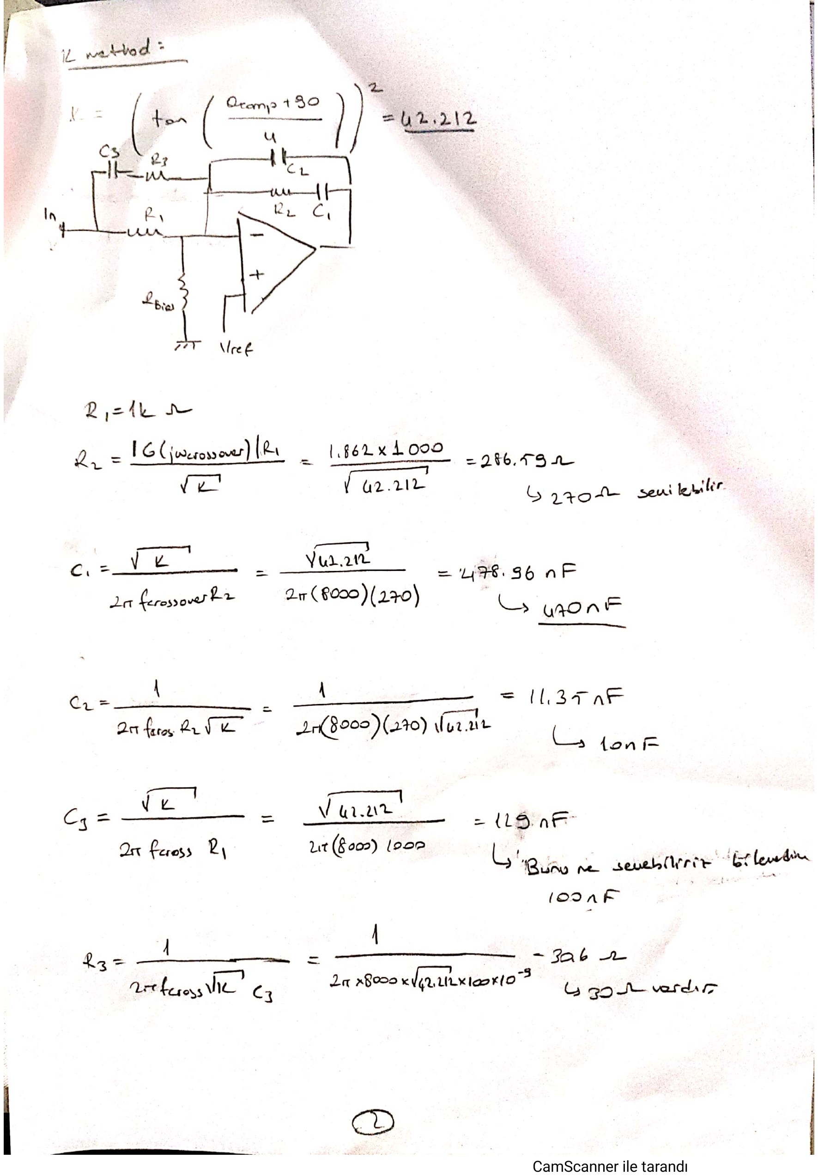
[picture p143: page 2]
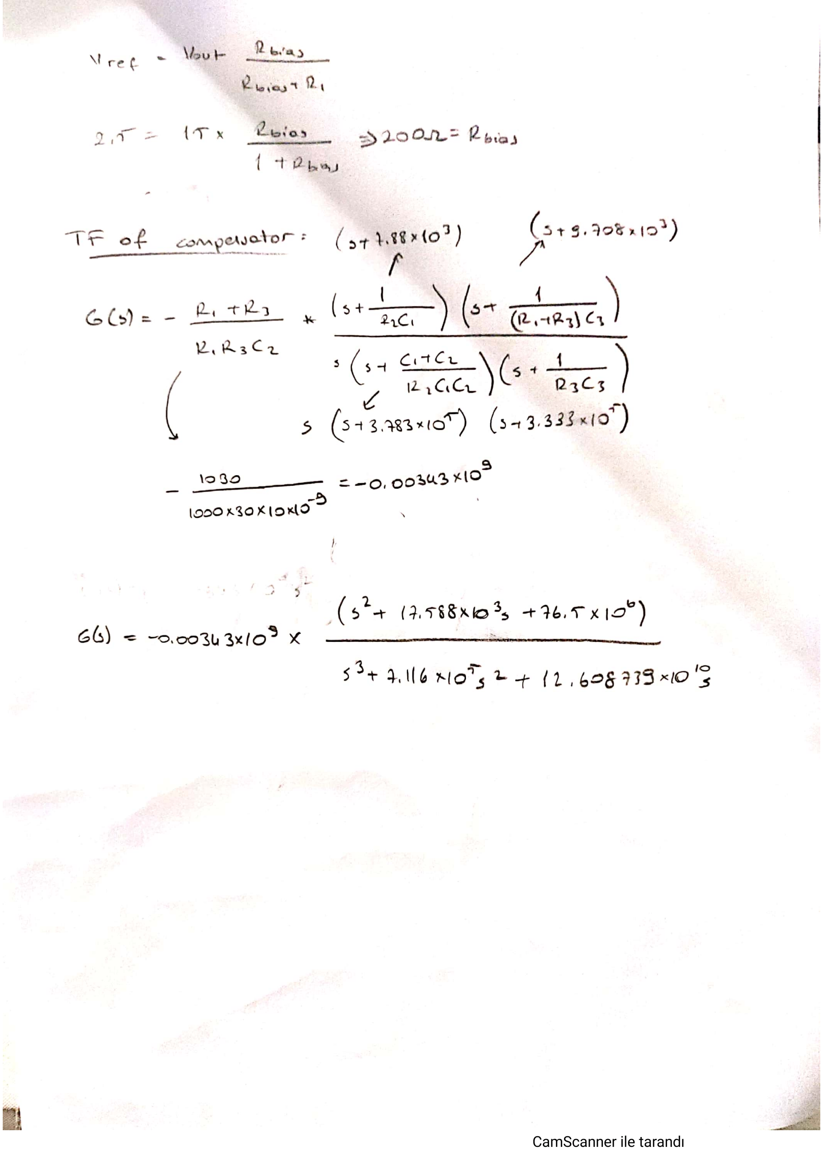
[picture p144: page 3]
