MERTAYDIN46/EE_464_hardware_project/Bode analysis of the open loop system.pdf

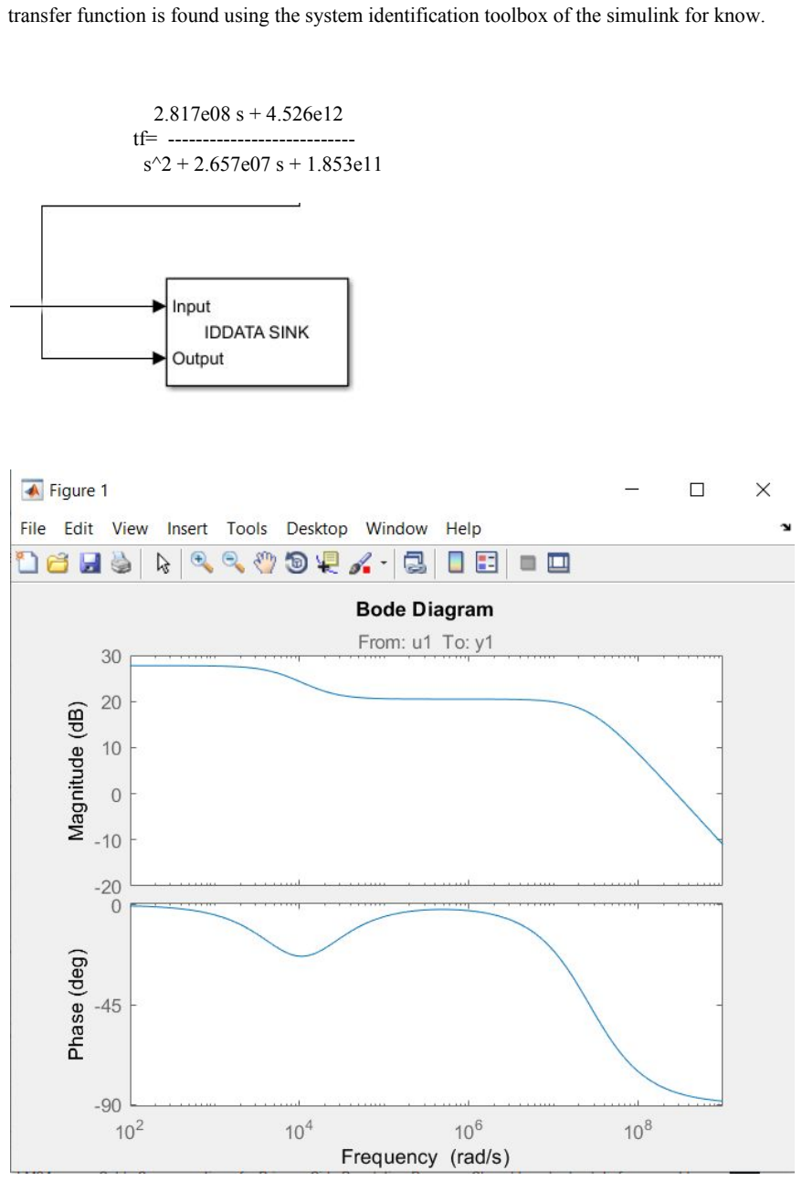
[picture p145: page 1]

transfer function is found using the system identification toolbox of the simulink for know.

2.817e08 s + 4.526e12
tf= ---------------------------s^2 + 2.657e07 s + 1.853e11
