MERTAYDIN46/EE_464_hardware_project/EE464_Hardware_Project_Final/f12.png

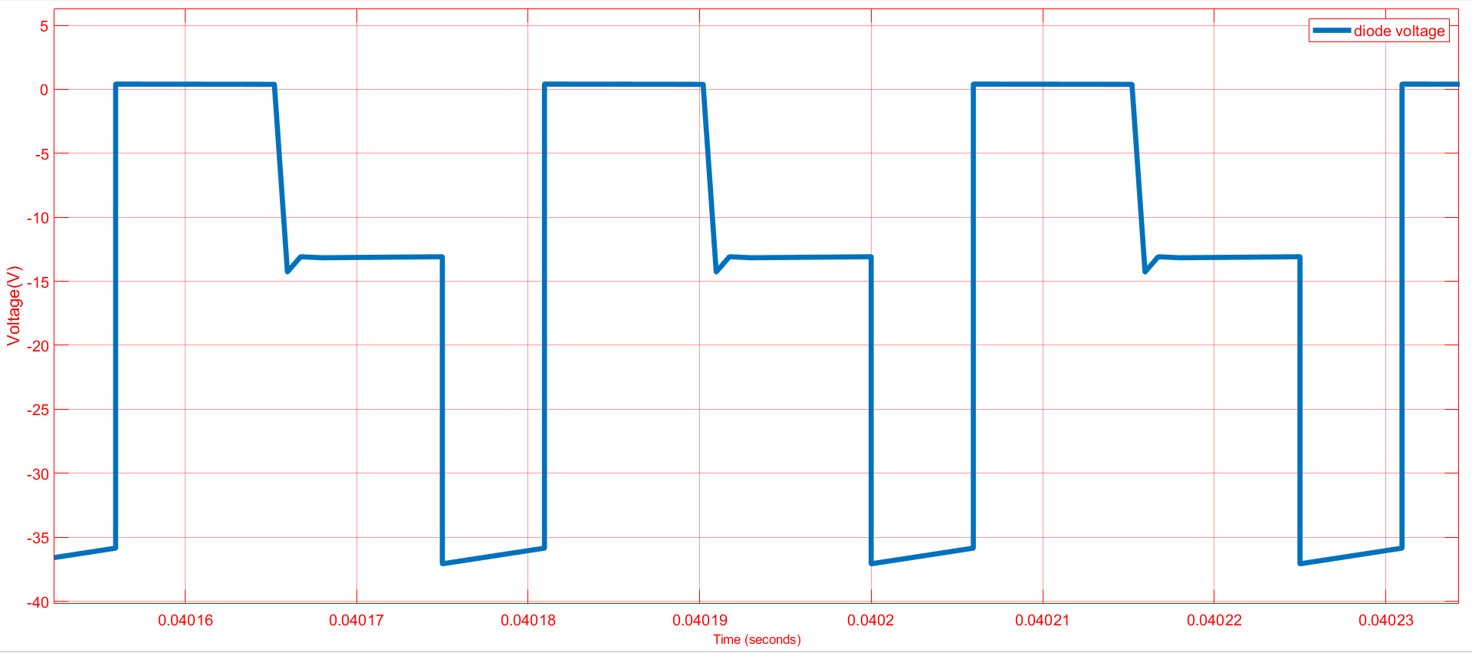
EE464_Hardware_Project_Final/f12.png
