MERTAYDIN46/EE_464_hardware_project/EE464_Hardware_Project_Final/fw others.PNG

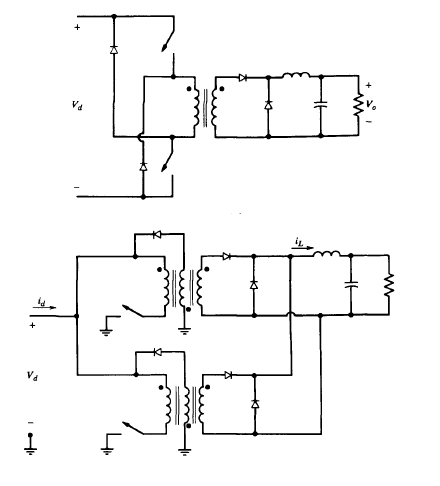
EE464_Hardware_Project_Final/fw others.PNG
