MERTAYDIN46/EE_464_hardware_project/EE464_Hardware_Project_Final/open loop with oscillator.jpg

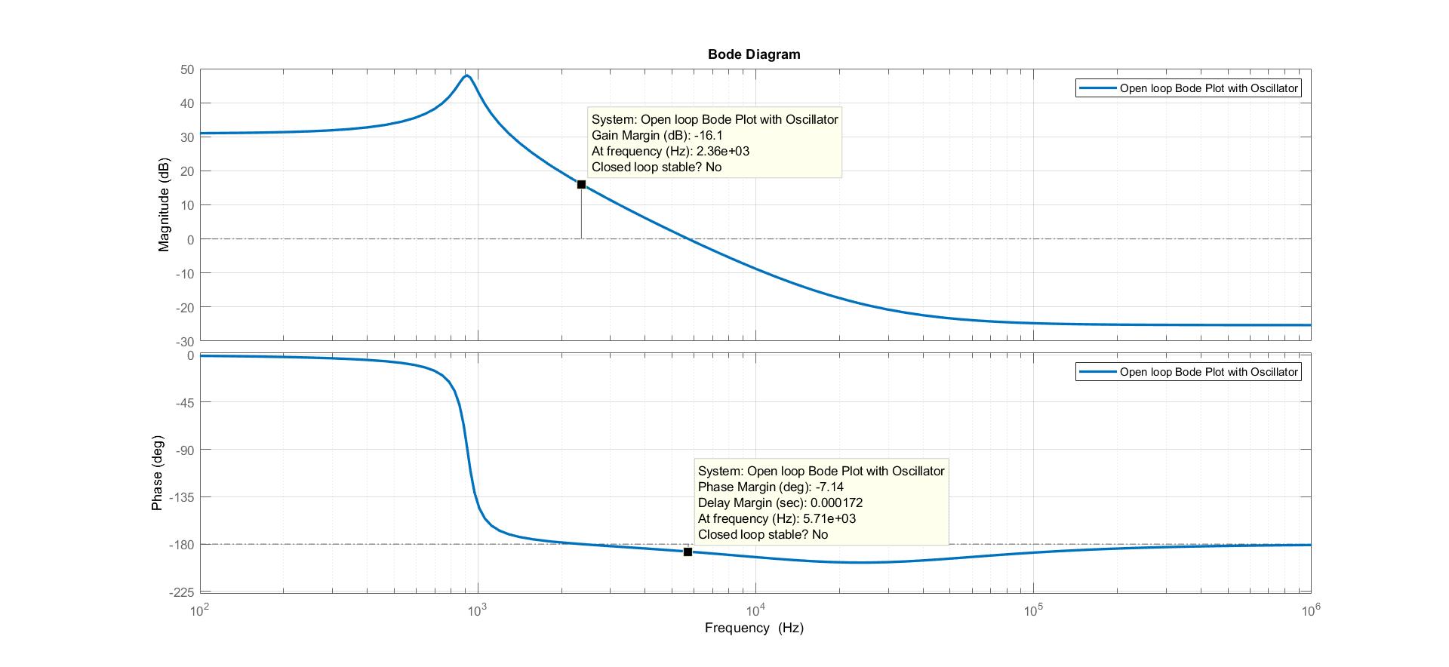
EE464_Hardware_Project_Final/open loop with oscillator.jpg
