MERTAYDIN46/EE_464_hardware_project/PCB_desing/Bill_of_Materials.xlsx

/export
/@version | /components/comp/@ref | /components/comp/footprint | /components/comp/libsource/@description | /components/comp/libsource/@lib | Manufacturer Part Number | /components/comp/value | Price | Number | Part Page
D | Q1 | Package_TO_SOT_THT:TO-220-3_Vertical | 33A Id, 100V Vds, HEXFET N-Channel MOSFET, TO-220 | Transistor_FET | IRF540NPBF | IRF540N | $0.97 | 1 | https://www.digikey.com/product-detail/en/infineon-technologies/IRF540NPBF/IRF540NPBF-ND/811869
D | R1 | Resistor_THT:R_Axial_DIN0204_L3.6mm_D1.6mm_P5.08mm_Horizontal | Resistor | Device | PR02000201001JR500 | 2k | $0.04845 | 2 | https://www.digikey.com/product-detail/en/vishay-bc-components/PR02000201001JR500/PPC1-0KW-2TR-ND/596130
D | C1 | Capacitor_THT:CP_Radial_D7.5mm_P2.50mm | Polarized capacitor | Device | TVA1207.7 | 200u | $1.60 | 1 | https://www.digikey.com/product-detail/en/vishay-sprague/TVA1207-7/TVA1207-7-ND/5612806
D | D1 | Package_TO_SOT_THT:TO-220-2_Vertical | Diode | Device | VT3080S-E3/4W | VT3080S | $1.29 | 1 | https://www.digikey.com/product-detail/en/vishay-semiconductor-diodes-division/VT3080S-E3-4W/VT3080S-E3-4WGI-ND/4934713
D | C2 | Capacitor_THT:CP_Radial_D12.5mm_P5.00mm | Polarized capacitor | Device |  | 330u | $1.05 | 1 | https://www.mouser.com.tr/datasheet/2/315/ABA0000C1255-1128316.pdf
D | J1 | Connector_BarrelJack:BarrelJack_CUI_PJ-063AH_Horizontal | DC Barrel Jack | Connector | PJ-054 | Barrel_Jack | $0.81 | 2 | https://www.digikey.com/product-detail/en/cui-devices/PJ-054/CP-054-ND/1644595
D | U1 | Package_DIP:DIP-8_W7.62mm | Controller IC | New_Library_0 | LT1246CN8#PBF | lt1246 | $2.95 | 1 | https://www.digikey.com/product-detail/en/linear-technology-analog-devices/LT1246CN8-PBF/LT1246CN8-PBF-ND/888961
D | R3 | Resistor_THT:R_Axial_DIN0204_L3.6mm_D1.6mm_P5.08mm_Horizontal | Resistor | Device | PR02000201001JR500 | 1k | $0.04845 | 1 | https://www.digikey.com/product-detail/en/vishay-bc-components/PR02000201001JR500/PPC1-0KW-2TR-ND/596130
D | C3 | Capacitor_THT:C_Disc_D3.4mm_W2.1mm_P2.50mm | Polarized capacitor | Device | C0603C183K5RACTU | 18.8nF | $0.01472 | 1 | https://www.digikey.com/product-detail/en/kemet/C0603C183K5RACTU/399-7868-2-ND/2200120
D | T1 | Transformer_THT:Transformer_CHK_EI54-12VA_1xSec | SMT Gate Drive Transformer, 1:1 | Transformer | MadenTURKEY | 0
D | J2 | Connector:Banana_Jack_1Pin | Generic connector, single row, 01x01, script generated (kicad-library-utils/schlib/autogen/connector/) | Connector_Generic | symbolize Output Holes | Conn_01x01
D | J3 | Connector:Banana_Jack_1Pin | Generic connector, single row, 01x01, script generated (kicad-library-utils/schlib/autogen/connector/) | Connector_Generic | symbolize Output Holes | Conn_01x01
D | R2 | Resistor_THT:R_Axial_DIN0204_L3.6mm_D1.6mm_P5.08mm_Horizontal | Resistor | Device | PR02000201001JR500 | 1k | $0.04845 | 1 | https://www.digikey.com/product-detail/en/vishay-bc-components/PR02000201001JR500/PPC1-0KW-2TR-ND/596130
D | R5 | Resistor_THT:R_Axial_DIN0204_L3.6mm_D1.6mm_P5.08mm_Horizontal | Resistor | Device | CFR-25JB-52-30R | 30 ohm | $0.1 | 1 | https://www.digikey.com/product-detail/en/yageo/CFR-25JB-52-30R/30QBK-ND/1526
D | C5 | Capacitor_THT:C_Disc_D3.4mm_W2.1mm_P2.50mm | Unpolarized capacitor | Device | GRM155R71C103KA01J | 100nF | $0.00238 | 1 | https://www.digikey.com/product-detail/en/murata-electronics/GRM155R71C103KA01J/490-6326-2-ND/2610890
D | C6 | Capacitor_THT:C_Disc_D3.4mm_W2.1mm_P2.50mm | Unpolarized capacitor | Device | C0402C102K5RACTU | 10nF | $0.0037 | 1 | https://www.digikey.com/product-detail/en/kemet/C0402C102K5RACTU/399-1032-2-ND/411034
D | C4 | Capacitor_THT:C_Disc_D3.4mm_W2.1mm_P2.50mm | Unpolarized capacitor | Device | C0402C474K9PACTU | 470nF | $0.01176 | 1 | https://www.digikey.com/product-detail/en/kemet/C0402C474K9PACTU/399-4899-2-ND/1090804
D | R4 | Resistor_THT:R_Axial_DIN0204_L3.6mm_D1.6mm_P5.08mm_Horizontal | Resistor | Device | CF14JT270R | 270 ohm | $0.00475 | 1 | https://www.digikey.com/product-detail/en/stackpole-electronics-inc/CF14JT270R/CF14JT270RTR-ND/1741362
D | R6 | Resistor_THT:R_Axial_DIN0204_L3.6mm_D1.6mm_P5.08mm_Horizontal | Resistor | Device | CF14JT200R | 200 ohm | $0.00475 | 1 | https://www.digikey.com/product-detail/en/stackpole-electronics-inc/CF14JT200R/CF14JT200RTR-ND/1741336
D | D2 | Diode_THT:D_A-405_P7.62mm_Horizontal | Diode | Device | 1N4007-T | D | $0.19000 | 1 | https://www.digikey.com/product-detail/en/diodes-incorporated/1N4007-T/1N4007DICT-ND/76454
D |  | Heatsink_Stone | Mechanical | Device | HSE-B20250-040H | M | $0.87 | 2 | https://www.mouser.ca/ProductDetail/CUI-Devices/HSE-B20250-040H?qs=5aG0NVq1C4x8typQNOePvQ%3D%3D
D
D
D
D
D
D
D
D
D
D
D
D
D
D
D
D
D
D
D
D
D
D
D
D
D
D
D
D
D
D
D
D
D
D
D
D
D
D
D
D
D
D
D
D
D
D
D
D
D
D
D
D
D
D
D
D
D
D
D
D
D
D
D
D
D
D
D
D
D
D
D
D
D
D
D
D
D
D
D
D
D
D
D
D
D
D
D
D
D
D
D
D
D
D
D
D
D
D
D
D
D
D
D
D
D
D
D
D
D
D
D
D
D
D
D
D
D
D
D
