MERTAYDIN46/EE_464_hardware_project/flyback controller (1).asc

C1: cap; 1.88e-8
C2: cap; 470µ; Rser=37m
C3: cap; 100n
C4: cap; 470n
C5: cap; 10n
D2: diode
L1: ind2; 77.138µ
L2: ind2; 34.22µ
R1: res; 3.75
R2: res; 1000
R3: res; 500
R4: res; 2000
R5: res; 200
R6: res; 0.015
R7: res; 30
U1: LT1246
U2: irf540n
V1: voltage; PULSE(48 24 0 1p 1p 0.1 0.2)
V2: voltage; 25
Named nets: 0
K L1 L2 1
.tran 0.2
.model D D(Ron=0.01333 Roff=1G Vfwd=0.39 Vrev=80 Ilimit=30)
