MERTAYDIN46/EE_464_hardware_project/Thermal circuit(works for ltspice4).asc

C1: cap; 330µ
C2: cap; 100n
C3: cap; 470n
C4: cap; 10n
D1: diode
L1: ind2; 77.138µ
L2: ind2; 34.22µ
M1: nmos; IRFH5306
R2: res; 15m
R3: res; 3.75
R4: res; 200
R5: res; 1k
R6: res; 30
R7: res; 270
U1: UniversalOpamp2
U2: UniversalOpamp2
U3: SOAtherm-HeatSink; Rtheta=10 Tambient=25
U4: SOAtherm-NMOS; Tambient=25
V1: voltage; 24
V3: voltage; 5
V4: voltage; 1.2
V6: voltage; PULSE(0 1.8 0 0 0.0000249 0 0.000025)
V7: voltage; 2.5
Named nets: 0
.tran 0.05
.model D D(Ron=0.01333 Roff=1G Vfwd=0.39 Vrev=80 Ilimit=30)
K L1 L2 1
