MERTAYDIN46/EE_464_hardware_project/PCB_desing/Hardwareproject.kicad_pcb

## KiCad design PCB_desing/Hardwareproject.kicad_pcb (2020-06-25)

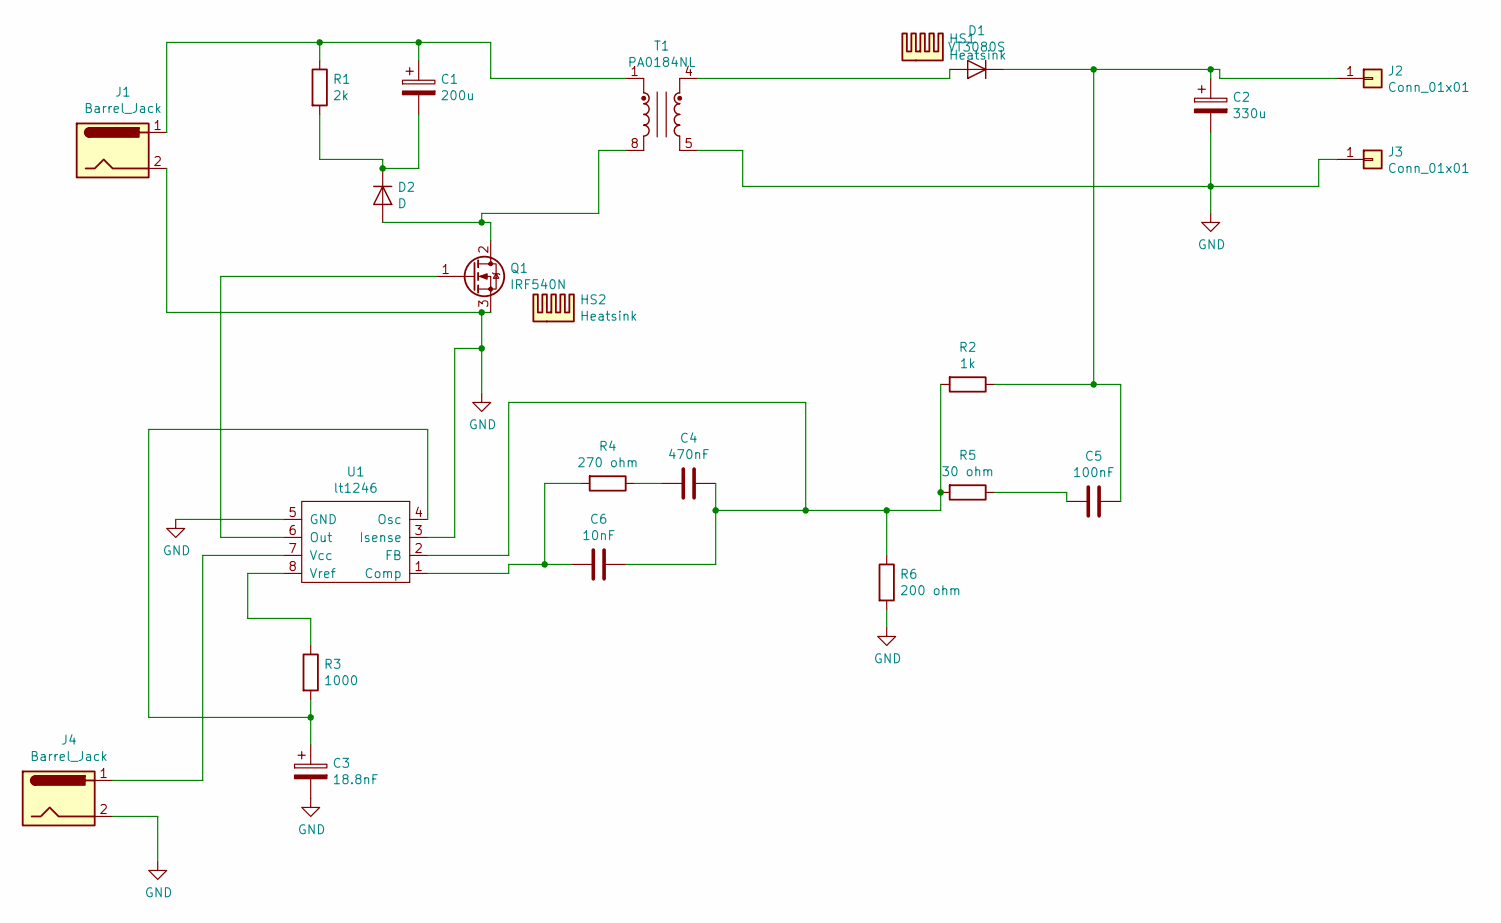
[picture p159: schematic Hardwareproject.sch]

Parts:
C1: 200u; CP_Radial_D7.5mm_P2.50mm
C2: 330u; CP_Radial_D12.5mm_P5.00mm
C3: 18.8nF; CP_EIA-3216-10_Kemet-I
C4: 470nF; CP_EIA-3216-10_Kemet-I
C5: 100nF; CP_EIA-3216-10_Kemet-I
C6: 10nF; CP_EIA-3216-10_Kemet-I
D1: VT3080S; TO-220-2_Vertical
D2: D; D_A-405_P7.62mm_Horizontal
HS1, HS2: Heatsink; Heatsink_Stonecold_HS-132_32x14mm_2xFixation1.5mm
J1, J4: Barrel_Jack; BarrelJack_CUI_PJ-063AH_Horizontal
J2, J3: Conn_01x01; Banana_Jack_1Pin
Q1: IRF540N; TO-220-3_Vertical
R1: 2k; R_Axial_DIN0204_L3.6mm_D1.6mm_P5.08mm_Horizontal
R2: 1k; R_Axial_DIN0204_L3.6mm_D1.6mm_P5.08mm_Horizontal
R3: 1000; R_Axial_DIN0204_L3.6mm_D1.6mm_P5.08mm_Horizontal
R4: 270 ohm; R_Axial_DIN0204_L3.6mm_D1.6mm_P5.08mm_Horizontal
R5: 30 ohm; R_Axial_DIN0204_L3.6mm_D1.6mm_P5.08mm_Horizontal
R6: 200 ohm; R_Axial_DIN0204_L3.6mm_D1.6mm_P5.08mm_Horizontal
T1: PA0184NL; Transformer_CHK_EI54-12VA_1xSec
U1: lt1246; DIP-8_W7.62mm

Connections:
GND: C2.2, C3.2, J1.2, J3.1, J4.2, Q1.3 (S), R6.2, T1.5, U1.3 (Isense), U1.5 (GND)
unnamed: C1.1, J1.1, R1.1, T1.1
unnamed: C1.2, D2.1 (K), R1.2
unnamed: C2.1, C5.1, D1.1 (K), J2.1, R2.1
unnamed: C3.1, R3.2, U1.4 (Osc)
unnamed: C4.1, C6.1, R2.2, R5.2, R6.1, U1.2 (FB)
unnamed: C4.2, R4.1
unnamed: C5.2, R5.1
unnamed: C6.2, R4.2, U1.1 (Comp)
unnamed: D1.2 (A), T1.4
unnamed: D2.2 (A), Q1.2 (D), T1.8
unnamed: J4.1, U1.7 (Vcc)
unnamed: Q1.1 (G), U1.6 (Out)
unnamed: R3.1, U1.8 (Vref)

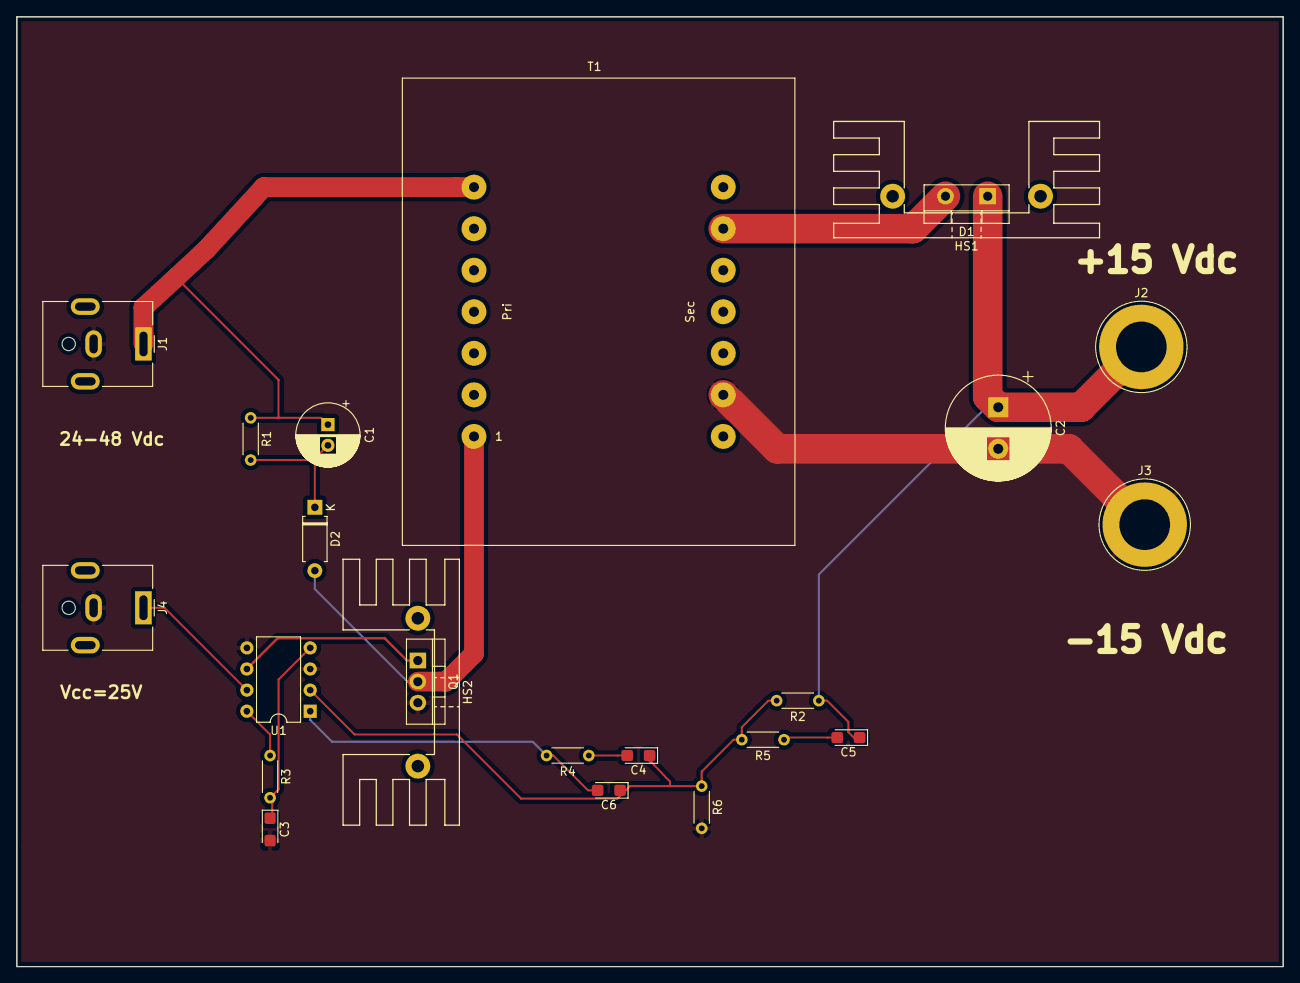
[picture p160: board Hardwareproject.kicad_pcb from above]

Board: 2 copper layers, 152.4 x 114.3 mm, 23 parts (0 on the bottom side), 14 nets.
