MERTAYDIN46/EE_464_hardware_project/(commit log)

2020-03-23 Formed Flyback design tool is added
    [flyback.xlsx]
2020-06-14 schematic is defined some foot prints are also assigned to components.
    [Hardwareproject.kicad_pcb, Hardwareproject.sch]
2020-06-24 All PCB is done, average switch network is created and transfer function tested.
    [Hardwareproject.kicad_pcb, Hardwareproject.sch, flyback.xlsx]
2020-06-24 All PCB work is done
    [Bill_of_Materials.xlsx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]
2020-06-24 Main circuit
2020-06-25 Final works
    [Bill_of_Materials.xlsx]
2020-06-25 Thermal test circuit
2020-06-25 Add files via upload
    In case of blurred or low resolution figures, I also share the overleaf source output of the final report.
